nikolayvidenov/Cryorefrigerator/Report/Figures/Top Plate V2.2.jpg

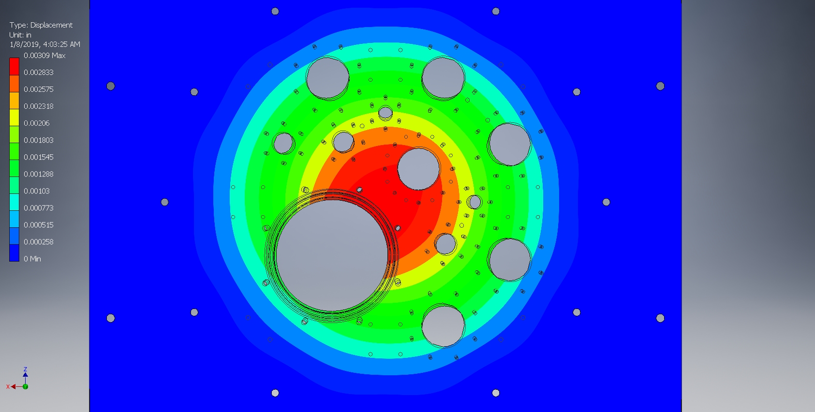
Report/Figures/Top Plate V2.2.jpg
