nikolayvidenov/Cryorefrigerator/Report/Figures/rhalf.jpg

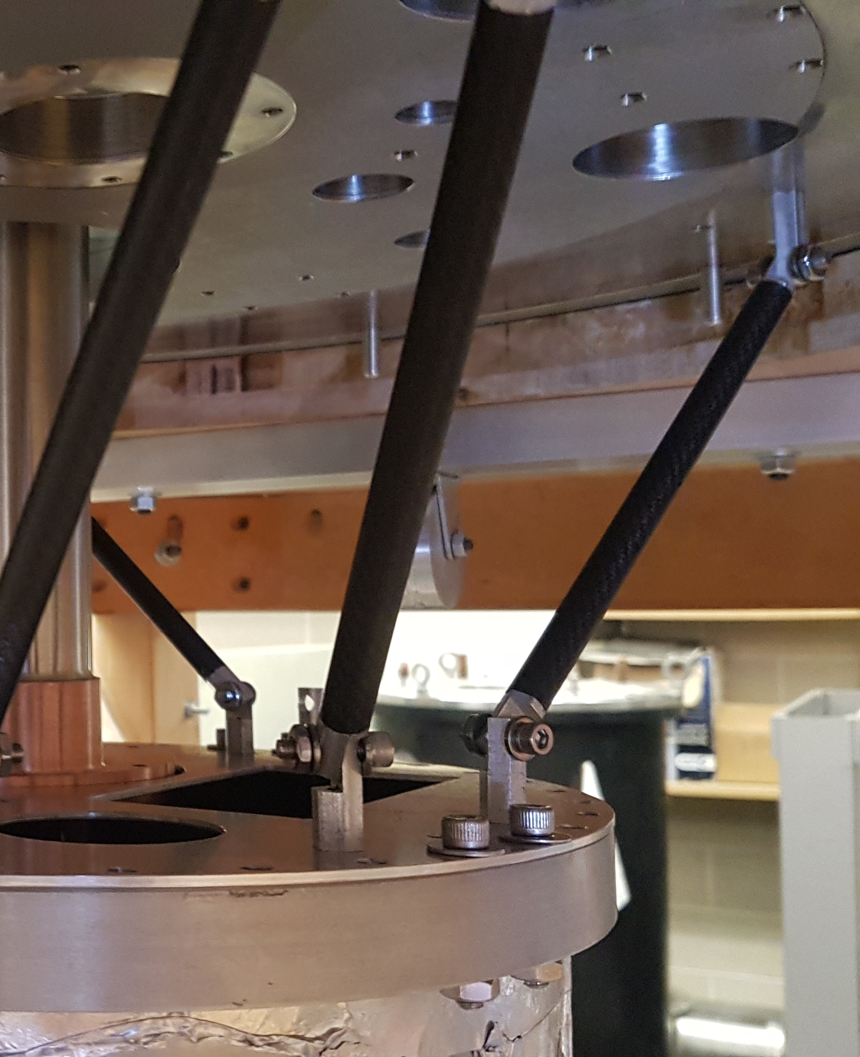
Report/Figures/rhalf.jpg
