nikolayvidenov/Cryorefrigerator/README.md

# Cryostat
Repository for a 4th year research project in cold physics.
