nikolayvidenov/Cryorefrigerator/CAD/References for the Plate Dimensions.docx

## References for the Plate Dimensions

https://www.idealvac.com/product.asp?pid=4601

https://www.lesker.com/newweb/flanges/flanges_technicalnotes_kf_1.cfm

https://www.idealvac.com/product.asp?pid=4599

10/10/18

http://www.mirapro.co.jp/english/products/tubing_components_01_clamps.html

https://www.lesker.com/newweb/flanges/hardware_kf_clamps_bulkhead.cfm?pgid=al
