nikolayvidenov/Cryorefrigerator/Articles/cooling power.PNG

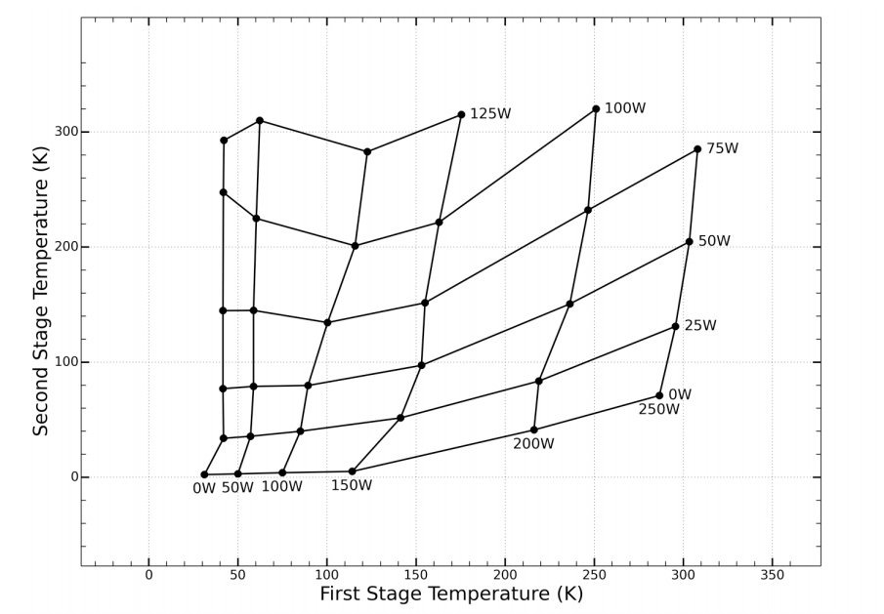
Articles/cooling power.PNG
