nikolayvidenov/Cryorefrigerator/CAD/External Models/Renderings/10-INCH-CLEAT20111201-24373-hxaudv.JPG

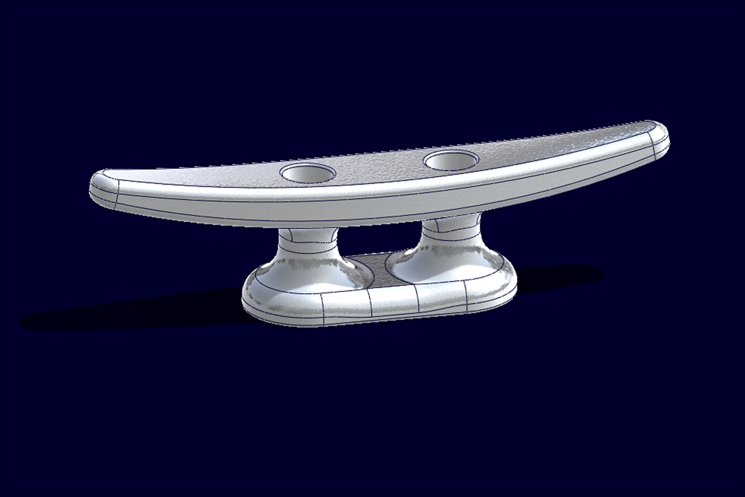
CAD/External Models/Renderings/10-INCH-CLEAT20111201-24373-hxaudv.JPG
