nikolayvidenov/Cryorefrigerator/CAD/lab view of cryostat.jpg

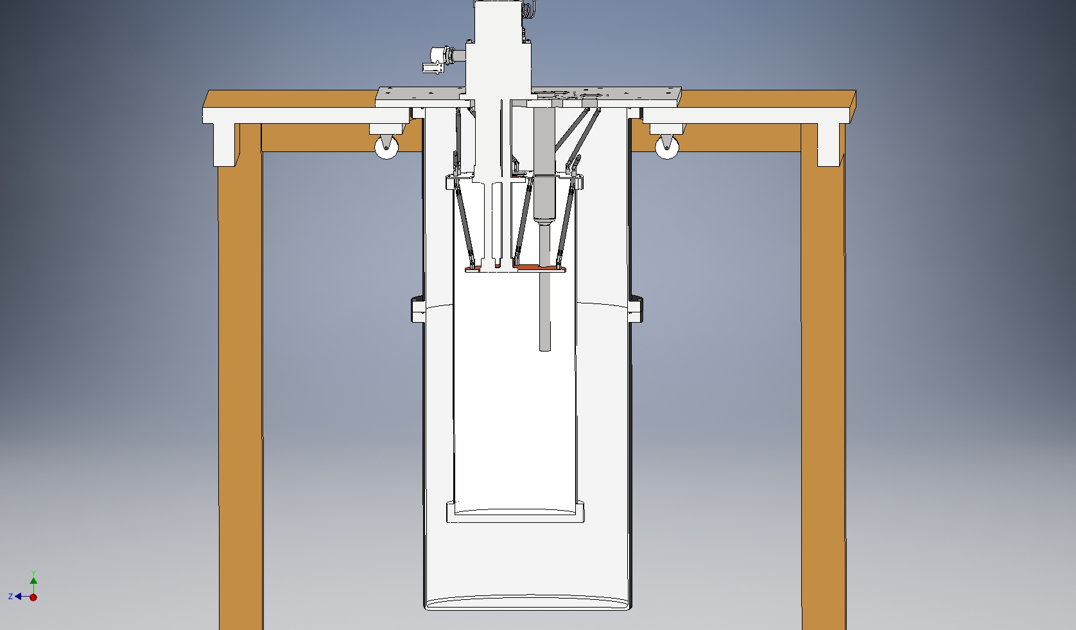
CAD/lab view of cryostat.jpg
