nikolayvidenov/Cryorefrigerator/CAD/stress analysis.jpg

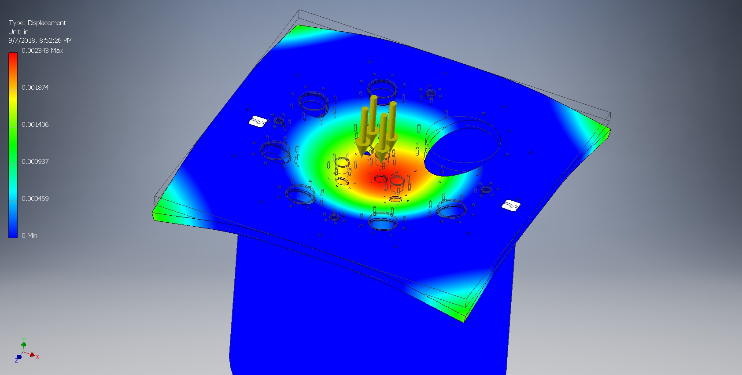
CAD/stress analysis.jpg
