nikolayvidenov/Cryorefrigerator/Calculations/Cool time from Heat Capacity.png

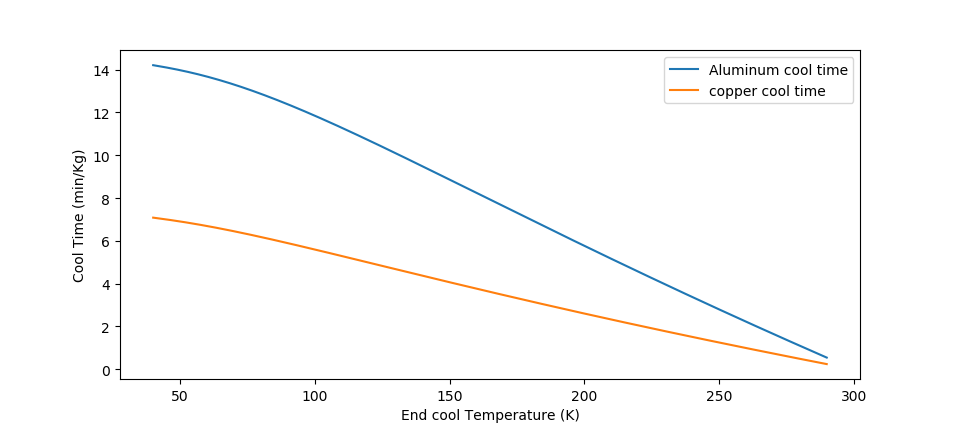
Calculations/Cool time from Heat Capacity.png
