nikolayvidenov/Cryorefrigerator/Cooling2.png

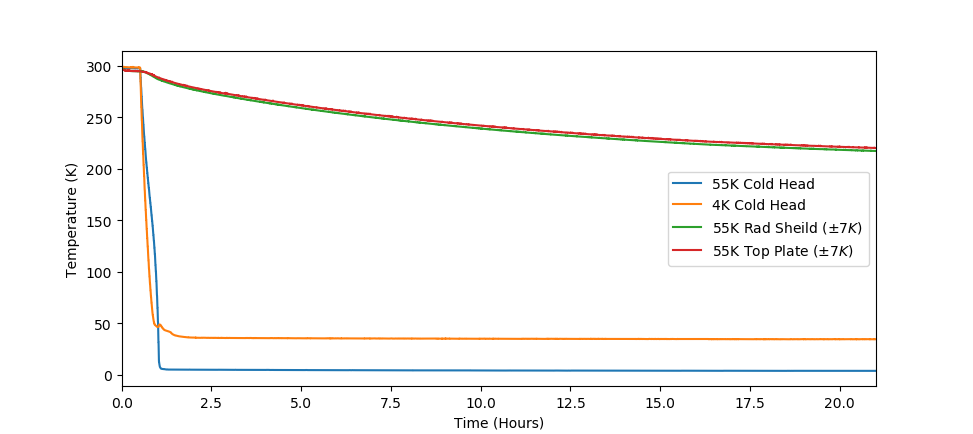
Cooling2.png
