nikolayvidenov/Cryorefrigerator/Cooling.png

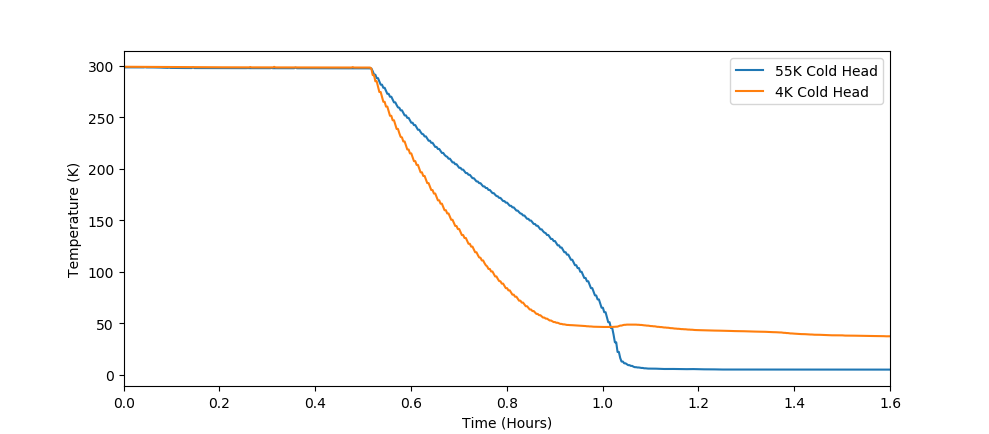
Cooling.png
