nikolayvidenov/Cryorefrigerator/Cryostat bottom.jpg

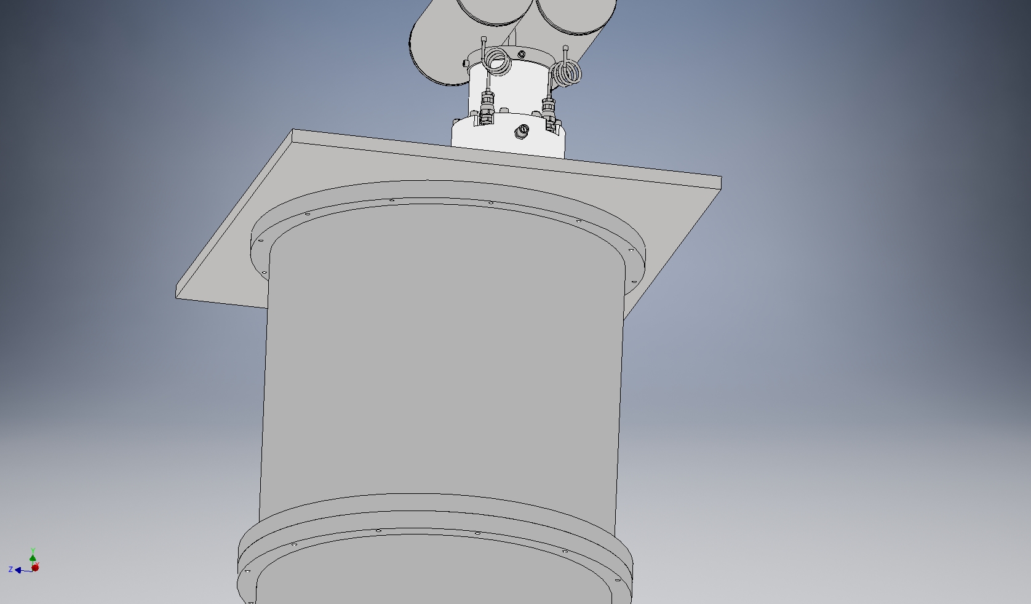
Cryostat bottom.jpg
