nikolayvidenov/Cryorefrigerator/Cryostat.jpg

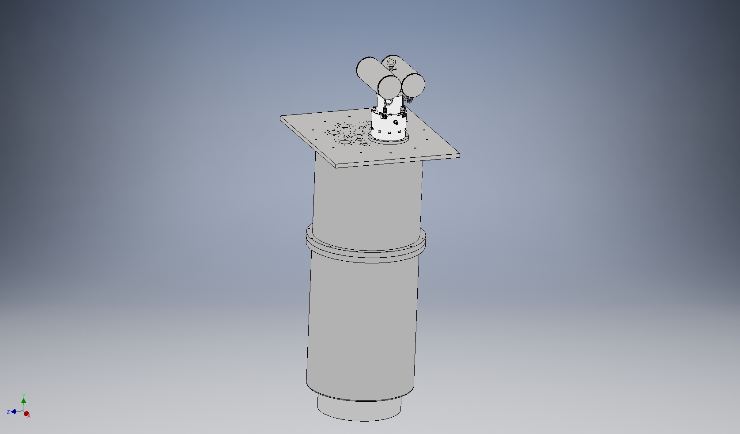
Cryostat.jpg
