nikolayvidenov/Cryorefrigerator/Diagram1.png

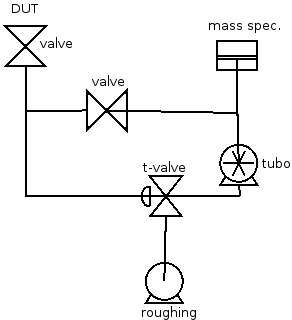
Diagram1.png
