nikolayvidenov/Cryorefrigerator/InkedCryostat bottom_LI.jpg

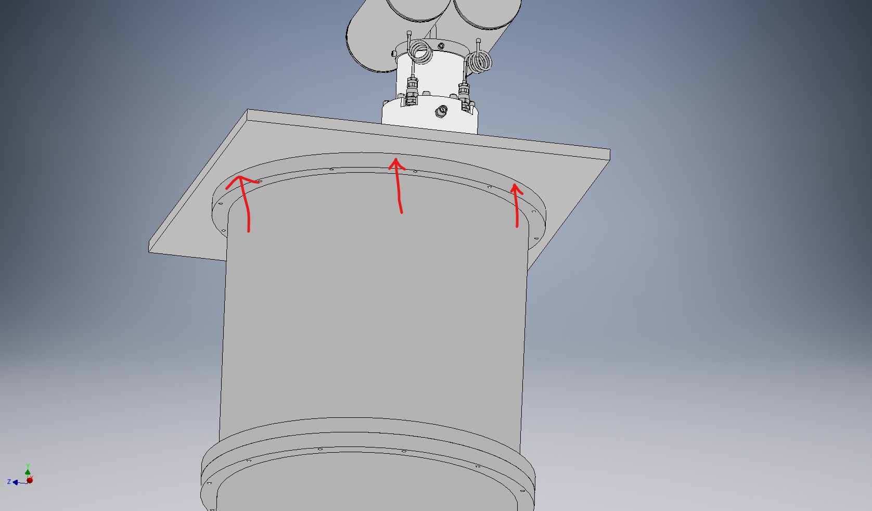
InkedCryostat bottom_LI.jpg
