nikolayvidenov/Cryorefrigerator/Report/Figures/4 wire.jpg

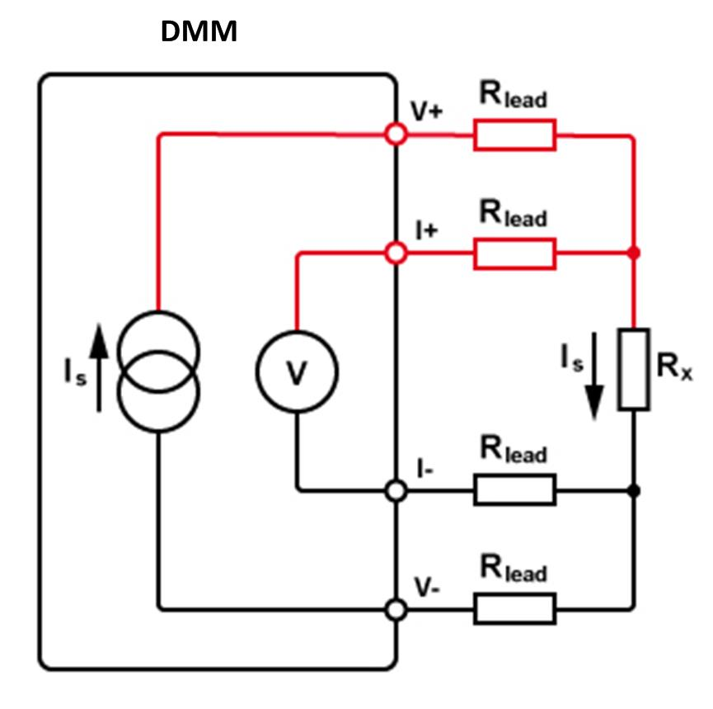
Report/Figures/4 wire.jpg
