nikolayvidenov/Cryorefrigerator/Report/Figures/ezgif.com-crop.gif

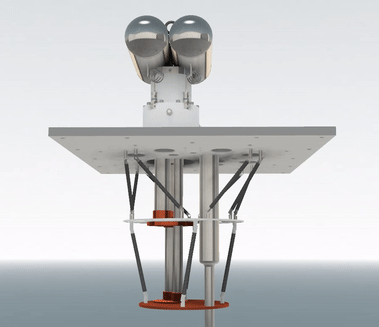
Report/Figures/ezgif.com-crop.gif
