nikolayvidenov/Cryorefrigerator/Report/Figures/foot type 3.jpg

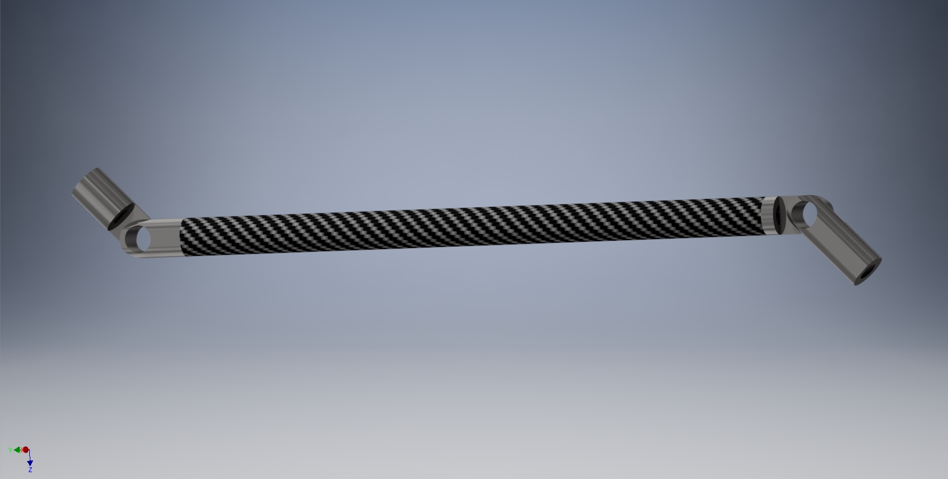
Report/Figures/foot type 3.jpg
