nikolayvidenov/Cryorefrigerator/Report/Figures/footCAD.jpg

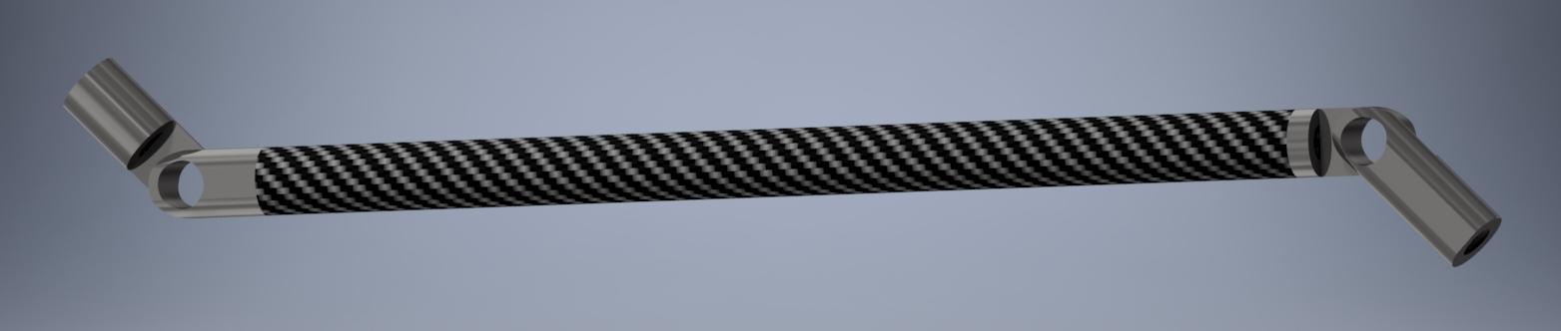
Report/Figures/footCAD.jpg
