nikolayvidenov/Cryorefrigerator/Report/Figures/heat capacity.png

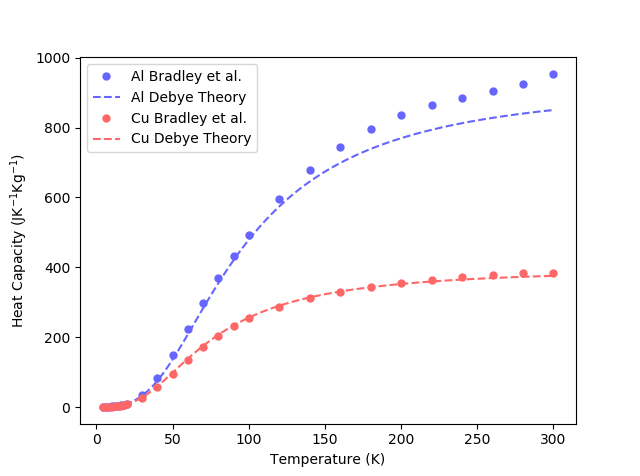
Report/Figures/heat capacity.png
