nikolayvidenov/Cryorefrigerator/Report/Figures/lab view of cryostat2.jpg

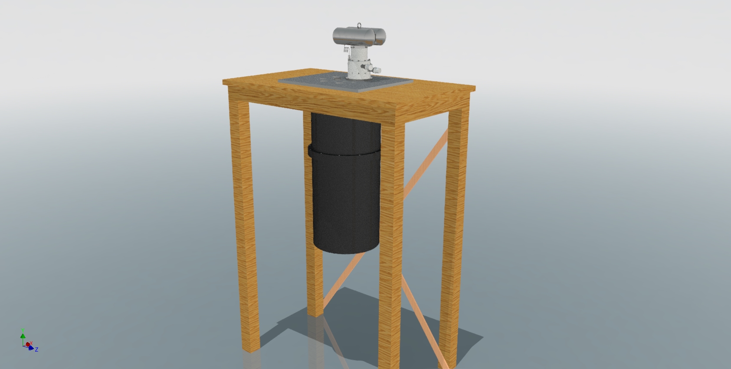
Report/Figures/lab view of cryostat2.jpg
