nikolayvidenov/Cryorefrigerator/Report/Figures/lab view of cryostat3.jpg

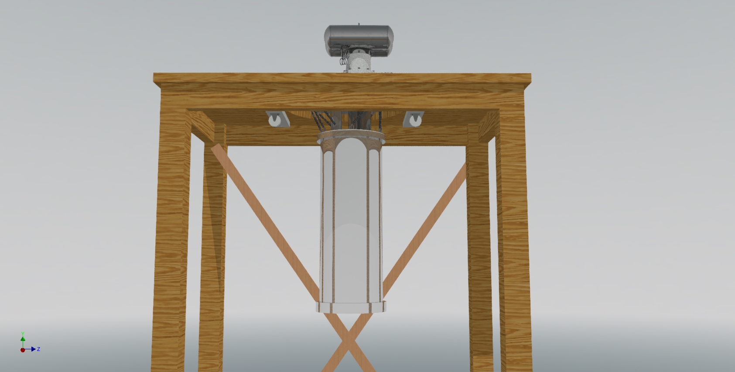
Report/Figures/lab view of cryostat3.jpg
