nikolayvidenov/Cryorefrigerator/Report/Figures/lab view of cryostat.jpg

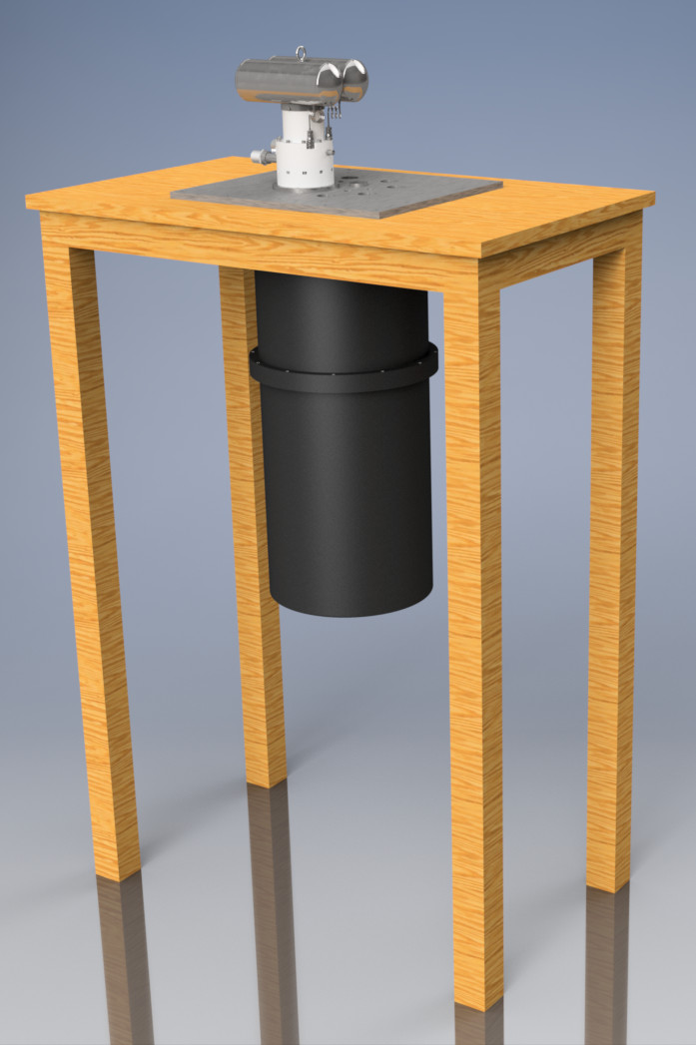
Report/Figures/lab view of cryostat.jpg
