nikolayvidenov/Cryorefrigerator/Report/Figures/lhalf.jpg

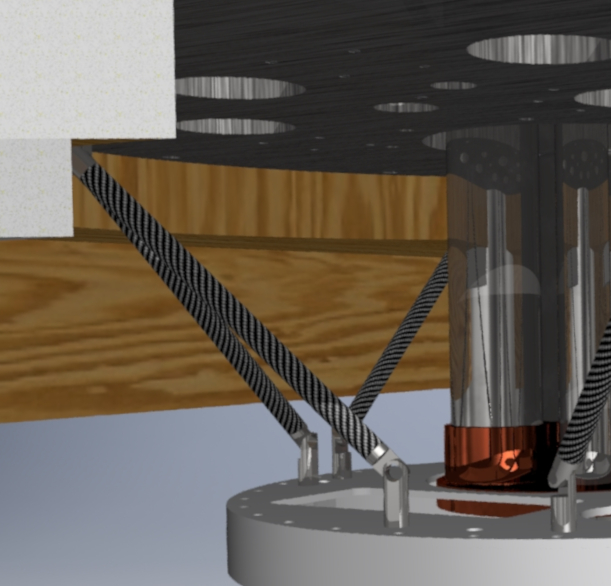
Report/Figures/lhalf.jpg
