nikolayvidenov/Cryorefrigerator/Report/Figures/mini 55K stage2.jpg

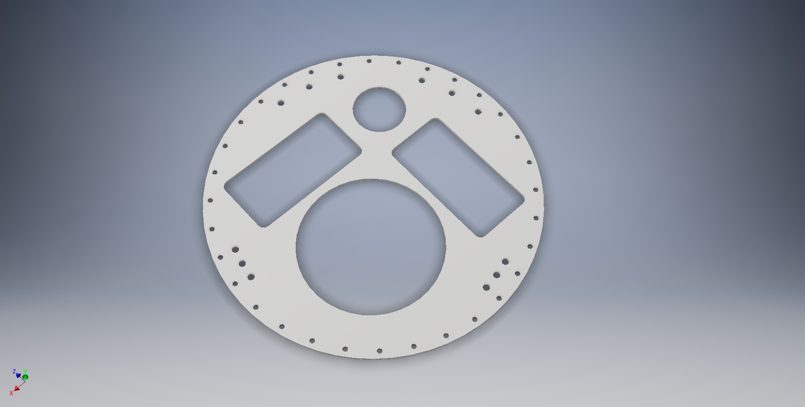
Report/Figures/mini 55K stage2.jpg
