nikolayvidenov/Cryorefrigerator/Report/Figures/mini 55K stage.jpg

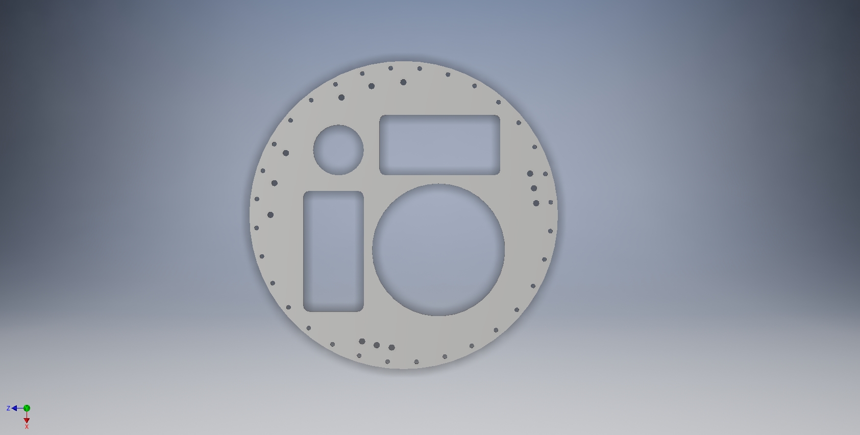
Report/Figures/mini 55K stage.jpg
