nikolayvidenov/Cryorefrigerator/Report/Figures/PTCOOLER.jpg

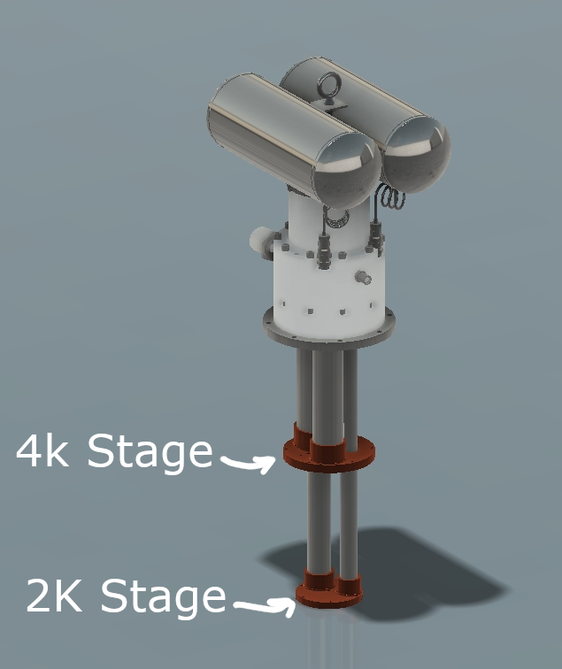
Report/Figures/PTCOOLER.jpg
