nikolayvidenov/Cryorefrigerator/Report/Figures/reallab view of cryostat.jpg

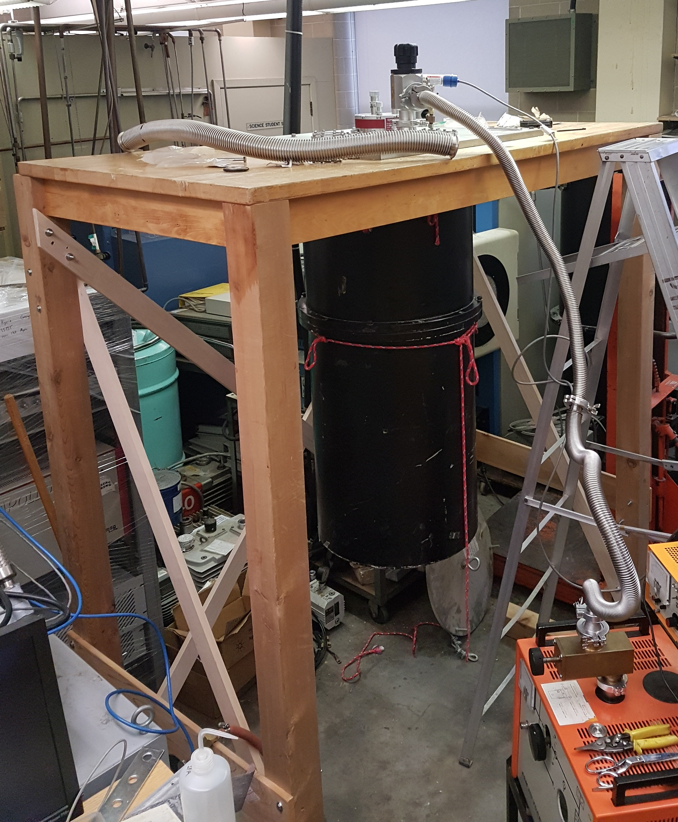
Report/Figures/reallab view of cryostat.jpg
