nikolayvidenov/Cryorefrigerator/Report/Figures/Top Plate V2.2 saftey factor.jpg

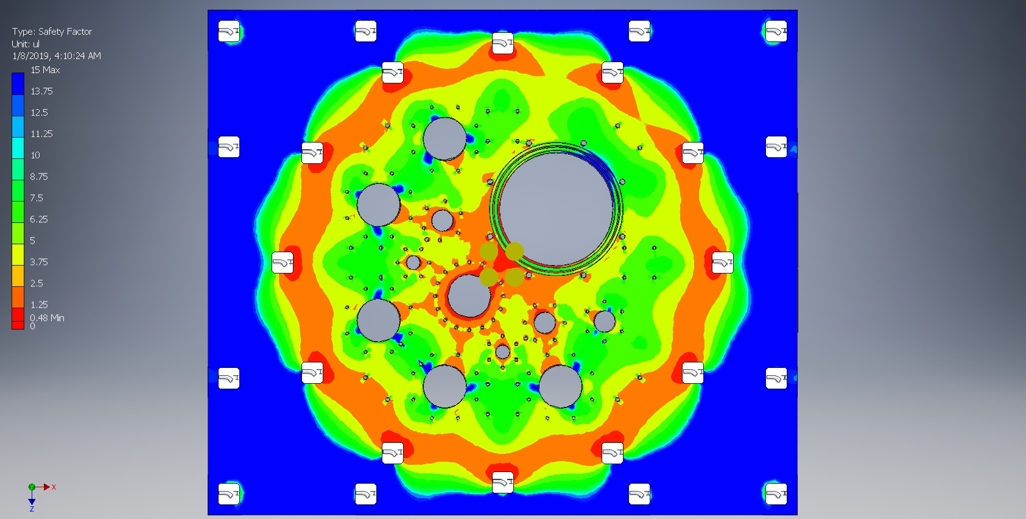
Report/Figures/Top Plate V2.2 saftey factor.jpg
