nikolayvidenov/Cryorefrigerator/Report/Figures/Top Plate V2.2 sideview.jpg

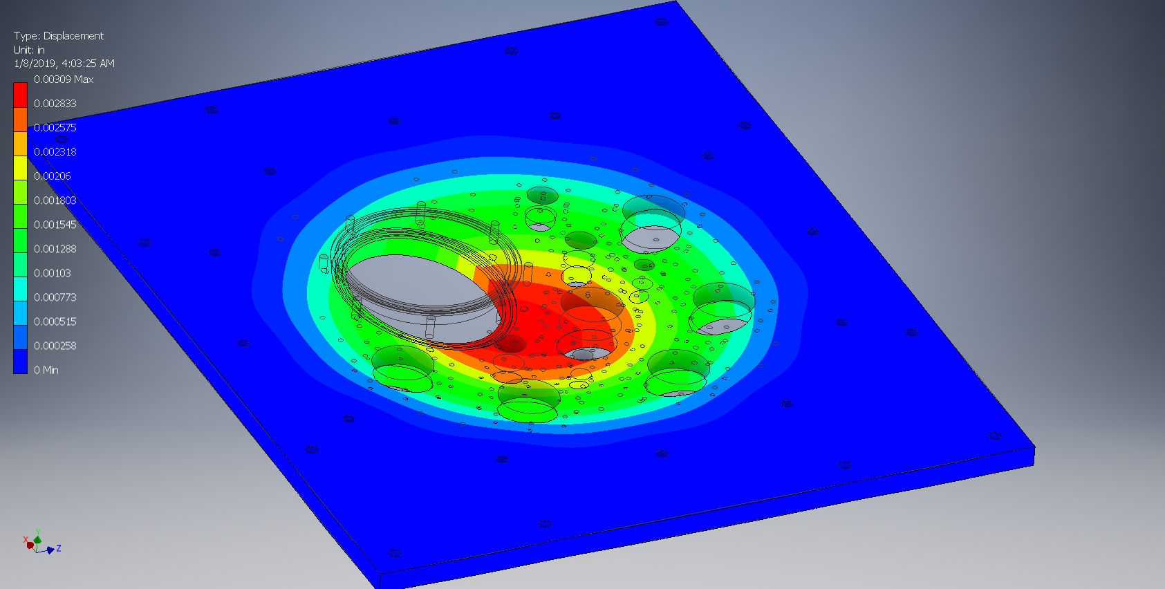
Report/Figures/Top Plate V2.2 sideview.jpg
