nikolayvidenov/Cryorefrigerator/Report/Figures/upview2.jpg

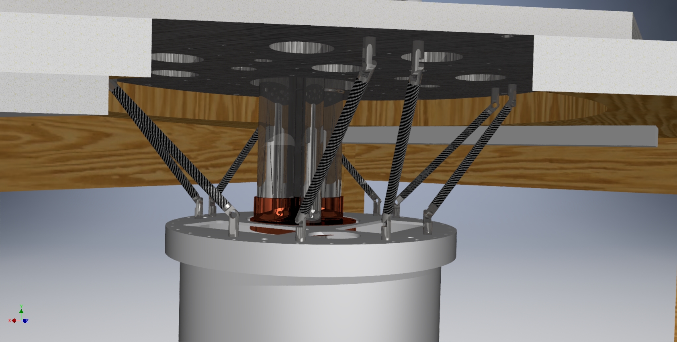
Report/Figures/upview2.jpg
