nikolayvidenov/Cryorefrigerator/Report/Figures/upview.jpg

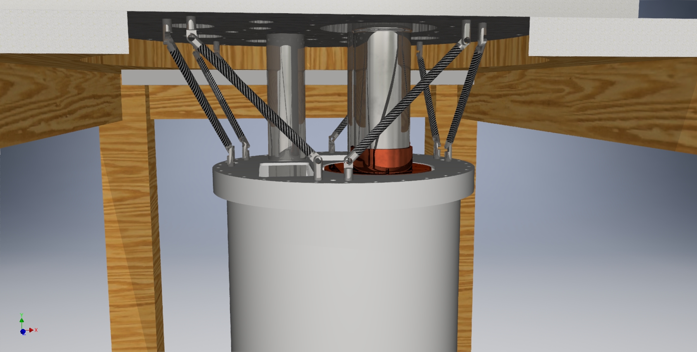
Report/Figures/upview.jpg
