nikolayvidenov/Cryorefrigerator/ReportB/Figures/4KColdHead.png

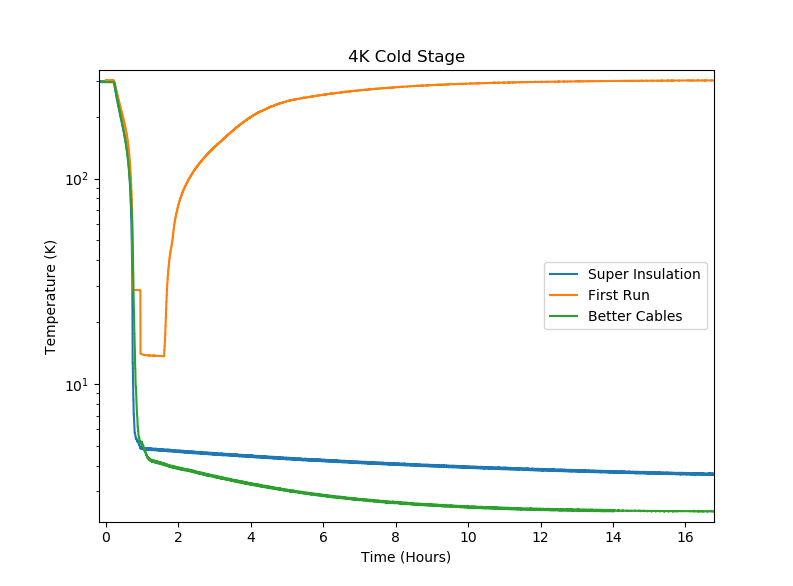
ReportB/Figures/4KColdHead.png
