nikolayvidenov/Cryorefrigerator/ReportB/Figures/55KColdHead.png

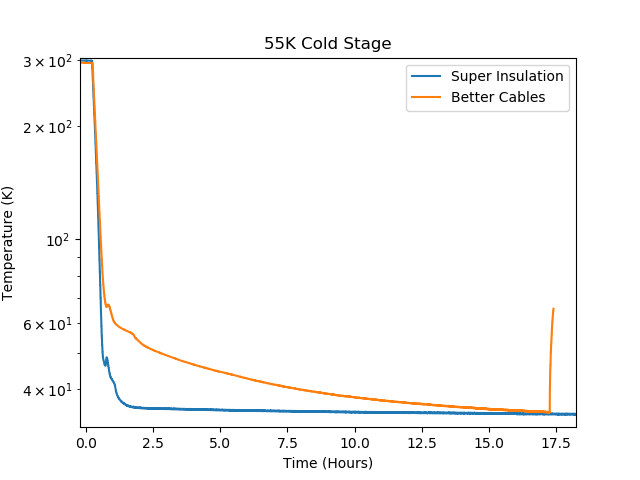
ReportB/Figures/55KColdHead.png
