nikolayvidenov/Cryorefrigerator/ReportB/Figures/55KScafolding.png

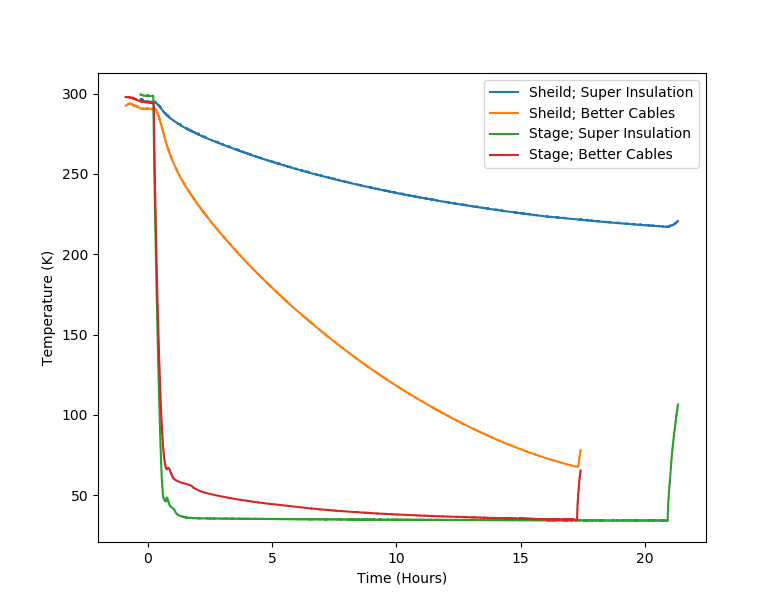
ReportB/Figures/55KScafolding.png
