nikolayvidenov/Cryorefrigerator/ReportB/Figures/mini Cryostat FOOT3.png

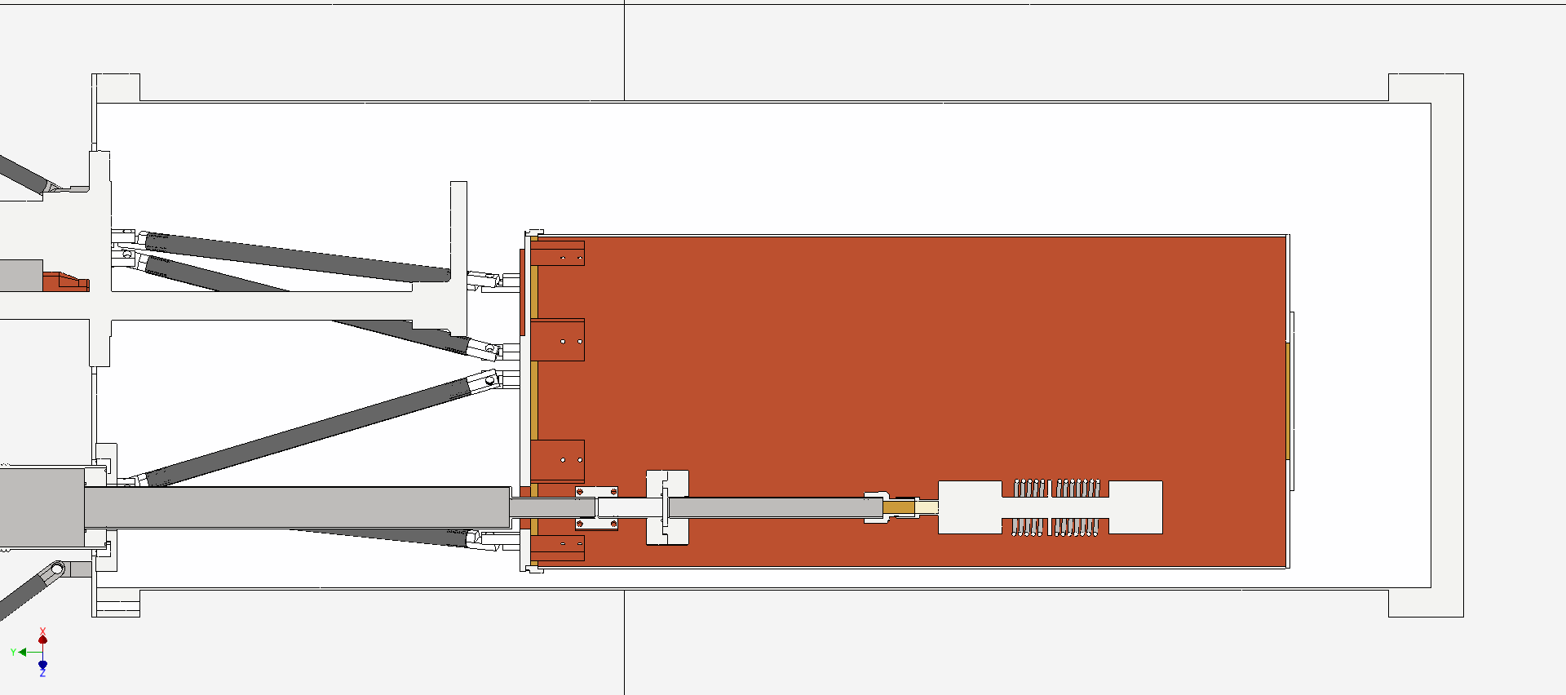
ReportB/Figures/mini Cryostat FOOT3.png
