nikolayvidenov/Cryorefrigerator/ReportB/Figures/mini Cryostat FOOT32.png

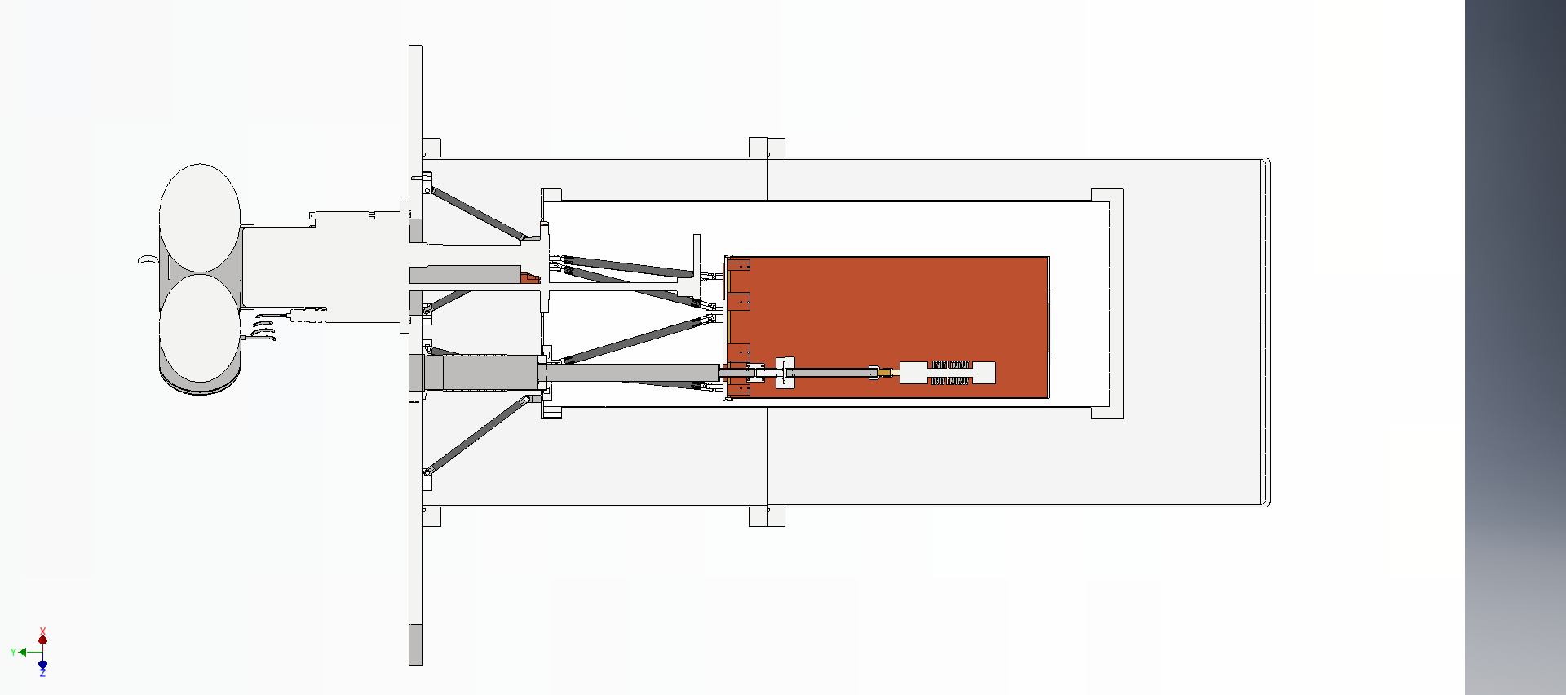
ReportB/Figures/mini Cryostat FOOT32.png
