nikolayvidenov/Cryorefrigerator/ReportB/Figures/still pipe.png

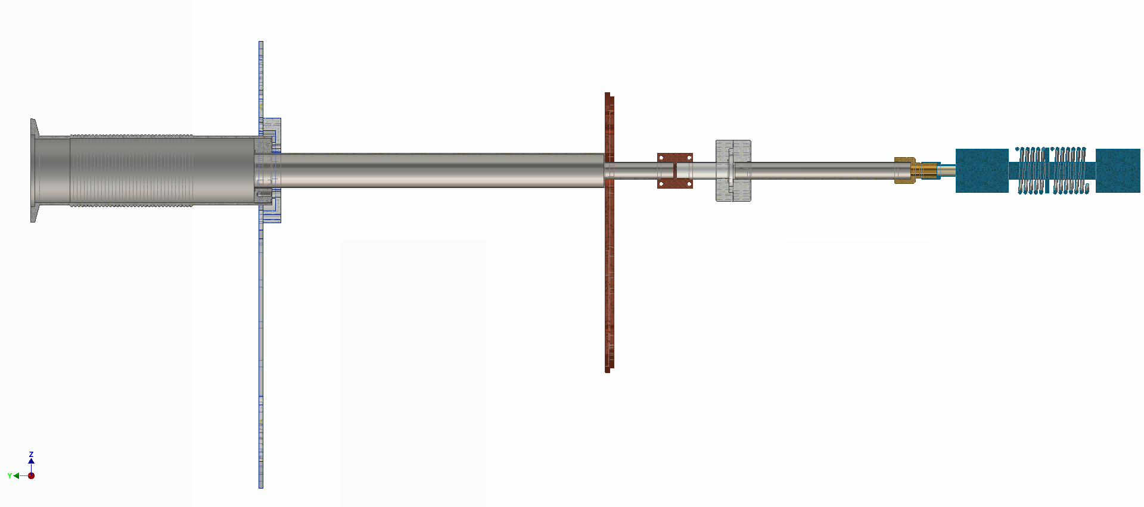
ReportB/Figures/still pipe.png
