nikolayvidenov/Cryorefrigerator/CAD/External Models/MARINE-CLEAT.STEP

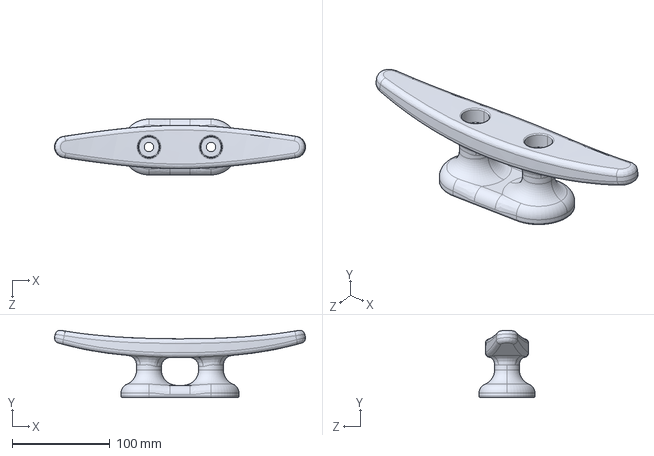
[picture p37: CAD file, 2018-10-26]
CAD/External Models/MARINE-CLEAT.STEP
256.9 x 69.1 x 57.2 mm
