nikolayvidenov/Cryorefrigerator/CAD/External Models/kf16 bulkhead clamp.stp

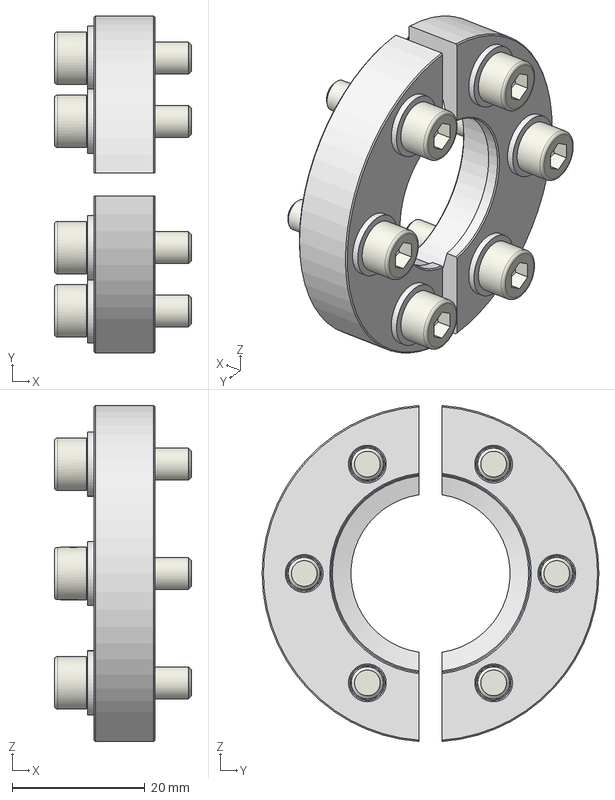
[picture p38: CAD file, 2018-09-08]
CAD/External Models/kf16 bulkhead clamp.stp
20.7 x 50.8 x 50.7 mm
QF16-075-BC
SOCKET HEAD CAP SCREW #10-32 x 6
WASHER #10 x 6
