nikolayvidenov/Cryorefrigerator/CAD/External Models/kf25 bulkhead clamp.stp

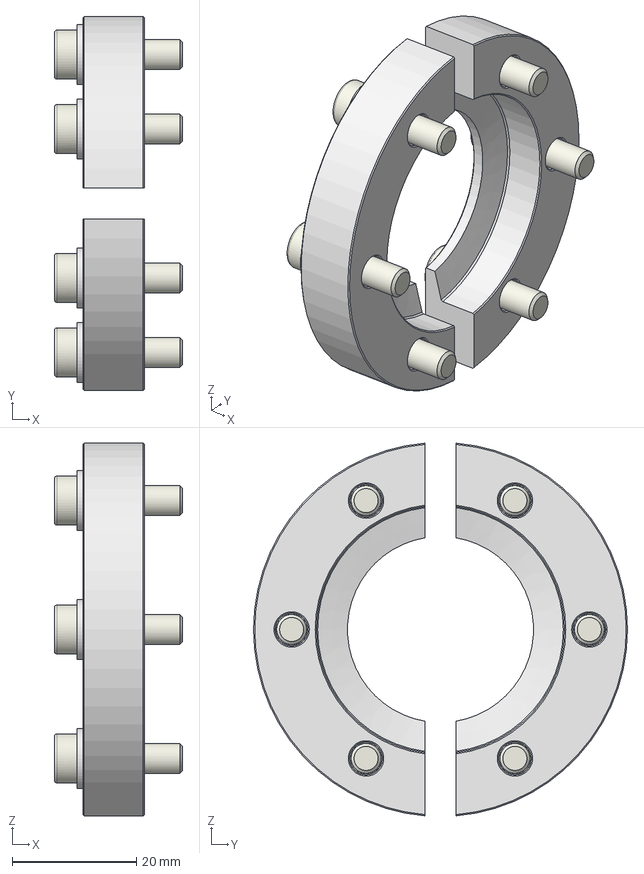
[picture p39: CAD file, 2018-08-22]
CAD/External Models/kf25 bulkhead clamp.stp
20.7 x 60.3 x 60.1 mm
QF25-100-BC
SOCKET HEAD CAP SCREW #10-32 x 6
WASHER #10 x 6
