nikolayvidenov/Cryorefrigerator/CAD/External Models/kf50 bulkhead clamp.stp

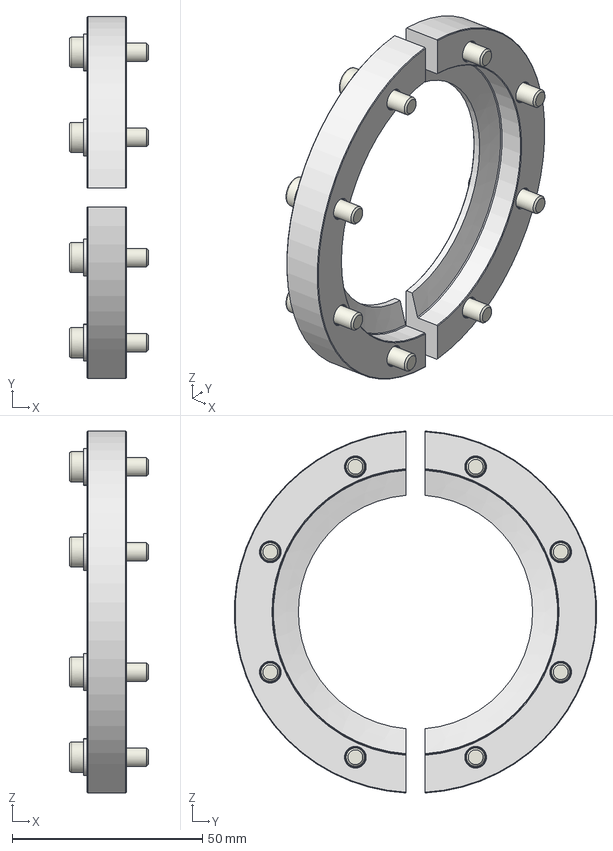
[picture p40: CAD file, 2018-08-22]
CAD/External Models/kf50 bulkhead clamp.stp
20.7 x 95.1 x 95.1 mm
QF50-200-BC
WASHER #10 x 8
SOCKET HEAD CAP SCREW #10-32 x 8
