nikolayvidenov/Cryorefrigerator/CAD/Top Plate V3 back holes.stp

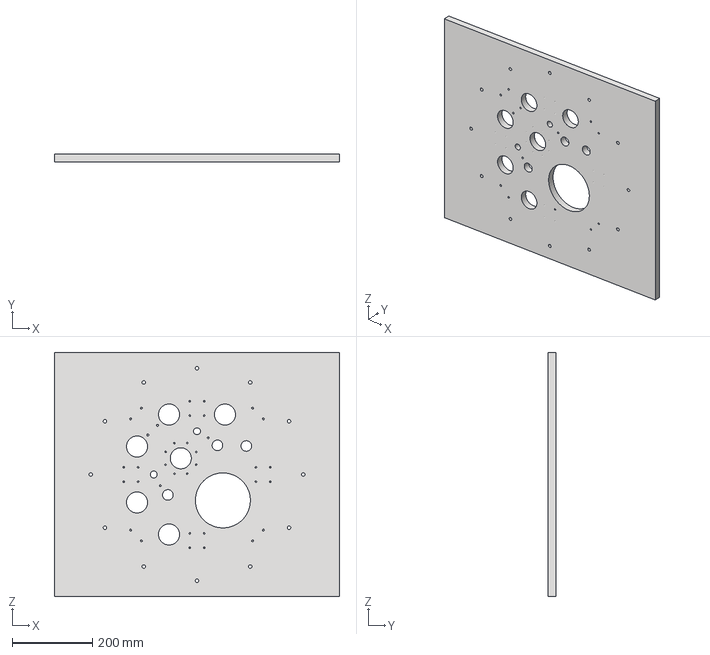
[picture p41: CAD file, 2018-11-19]
CAD/Top Plate V3 back holes.stp
711.2 x 19.0 x 609.6 mm
