nikolayvidenov/Cryorefrigerator/CAD/Top Plate.stp

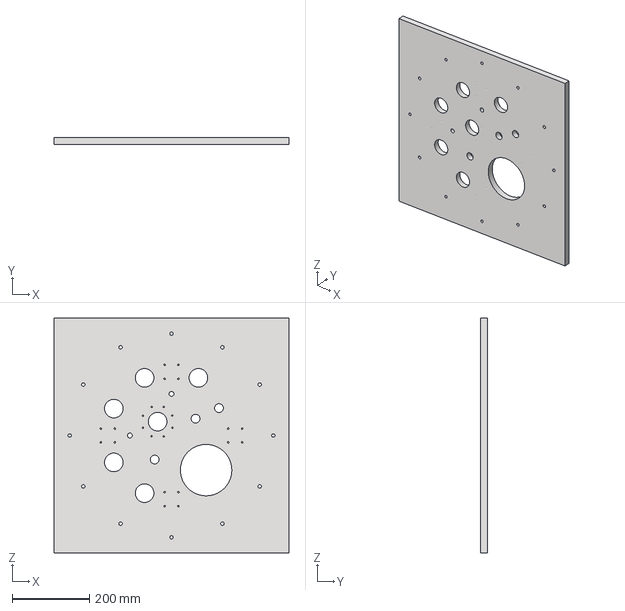
[picture p42: CAD file, 2018-09-15]
CAD/Top Plate.stp
609.6 x 19.1 x 609.6 mm
