nikolayvidenov/Cryorefrigerator/(list of files, cad)

Other CAD files:
CAD/universal connector male.dwg
CAD/still pipe.dwg
CAD/heatsink.dwg
CAD/fridge bushing.dwg
CAD/adapter.dwg
CAD/brassbushing2.dwg
CAD/mount.dwg
CAD/TF JunctionBoard.dwg
CAD/TF readoutSquid.dwg
CAD/8 trace.dwg
CAD/teflonlense assem.dwg
CAD/feet type 3 part 1.dwg
CAD/feet type 3 part 2.dwg
CAD/Top Plate V2 mounting holes.dwg
CAD/Top Plate V2 PT415 moved in.dwg
CAD/Top Plate PT415 grooves.dwg
CAD/Top Plate V2.2.dwg
CAD/Top Plate V2 oring.dwg
CAD/Top Plate Dimentions KF16.dwg
CAD/Top Plate Simple.dwg
CAD/Top Plate Dimentions KF25.dwg
CAD/Top Plate Dimentions KF50.dwg
CAD/Top Plate Dimentions.dwg
CAD/0in5 ss pipe.ipt
CAD/1in ss pipe.ipt
CAD/2K8 FEET long.iam
CAD/2K8 FEET.iam
CAD/2K8 stage mini.ipt
CAD/2K8 stage.ipt
CAD/4K adapter.ipt
CAD/4K heatsink bushing.ipt
CAD/4K sheild body.ipt
CAD/4K sheild body2.ipt
CAD/4K sheild rim.ipt
CAD/4K sheild rim2.ipt
CAD/4K sheild rim3.ipt
CAD/4K sheild top.ipt
CAD/4K shield bottom.ipt
CAD/4K shield cover.ipt
CAD/4K shield.iam
CAD/4K shield2.iam
CAD/55K mini shield.ipt
CAD/55K shield sheet.ipt
CAD/55K stage comparison.iam
CAD/55K stage.ipt
CAD/8 trace.ipt
CAD/Cryostat top plate.iam
CAD/Cryostat.iam
CAD/External Models/CH40415 24JUL14 C.ipt
CAD/External Models/CH40415 24JUL14 C.stp
CAD/External Models/MARINE-CLEAT.ipt
CAD/External Models/MARINE-CLEAT.stl
CAD/External Models/OldVersions/CH40415 24JUL14 C.0003.ipt
CAD/External Models/OldVersions/MARINE-CLEAT.0001.ipt
CAD/External Models/OldVersions/SOCKET HEAD CAP SCREW #10-32.0001.ipt
CAD/External Models/OldVersions/SOCKET HEAD CAP SCREW #10-32.0002.ipt
CAD/External Models/OldVersions/WASHER #10.0001.ipt
CAD/External Models/OldVersions/WASHER #10.0002.ipt
CAD/External Models/OldVersions/kf16 bulkhead clamp.0001.iam
CAD/External Models/QF16-075-BC.ipt
CAD/External Models/QF25-100-BC.ipt
CAD/External Models/QF50-200-BC.ipt
CAD/External Models/SOCKET HEAD CAP SCREW #10-32.ipt
CAD/External Models/WASHER #10.ipt
CAD/External Models/kf16 bulkhead clamp.iam
CAD/External Models/kf25 bulkhead clamp.iam
CAD/External Models/kf50 bulkhead clamp.iam
CAD/KF50 bellows.ipt
CAD/OldVersions/0in5 ss pipe.0001.ipt
CAD/OldVersions/1in ss pipe.0012.ipt
CAD/OldVersions/2K8 FEET long.0011.iam
CAD/OldVersions/2K8 FEET.0012.iam
CAD/OldVersions/2K8 stage mini.0007.ipt
CAD/OldVersions/2K8 stage.0002.ipt
CAD/OldVersions/4K heatsink bushing.0003.ipt
CAD/OldVersions/4K sheild rim3.0001.ipt
CAD/OldVersions/4K sheild top.0021.ipt
CAD/OldVersions/4K shield bottom.0002.ipt
CAD/OldVersions/4K shield2.0009.iam
CAD/OldVersions/55K mini shield.0004.ipt
CAD/OldVersions/55K shield sheet.0001.ipt
CAD/OldVersions/55K stage.0020.ipt
CAD/OldVersions/8 trace.0001.ipt
CAD/OldVersions/Cryostat top plate.0005.iam
CAD/OldVersions/Cryostat top plate.0006.iam
CAD/OldVersions/Cryostat.0016.iam
CAD/OldVersions/KF50 bellows.0008.ipt
CAD/OldVersions/Radiation Sheild 2K.0004.ipt
CAD/OldVersions/TF JunctionBoard.0002.ipt
CAD/OldVersions/TF readoutSquid.0001.ipt
CAD/OldVersions/Top Plate Dimentions KF16.0003.dwg
CAD/OldVersions/Top Plate Dimentions KF25.0003.dwg
CAD/OldVersions/Top Plate Dimentions KF50.0003.dwg
CAD/OldVersions/Top Plate Dimentions.0005.dwg
CAD/OldVersions/Top Plate PT415 grooves.0003.dwg
CAD/OldVersions/Top Plate Simple.0001.dwg
CAD/OldVersions/Top Plate V2 mounting holes.0004.dwg
CAD/OldVersions/Top Plate V2.0007.ipt
CAD/OldVersions/Top Plate V2.2.0023.ipt
CAD/OldVersions/Top Plate.0015.ipt
CAD/OldVersions/Top Plate.0032.ipt
CAD/OldVersions/adapter.0001.dwg
CAD/OldVersions/adapter.0010.ipt
CAD/OldVersions/analysis.0003.iam
CAD/OldVersions/analysis.0004.iam
CAD/OldVersions/brassbushing2.0001.dwg
CAD/OldVersions/brassbushing2.0004.ipt
CAD/OldVersions/existing copper plate 1.0001.ipt
CAD/OldVersions/existing copper plate 2.0001.ipt
CAD/OldVersions/feet type 1 part 2.0001.ipt
CAD/OldVersions/feet type 1 part 2.0002.ipt
CAD/OldVersions/feet type 1 part 2.0003.ipt
CAD/OldVersions/feet type 2 part 1.0001.ipt
CAD/OldVersions/feet type 2 part 2 long.0001.ipt
CAD/OldVersions/feet type 2 part 2.0001.ipt
CAD/OldVersions/feet type 2 part 2.0002.ipt
CAD/OldVersions/feet type 3 part 1 hexagon stock 10-32 hole.0002.ipt
CAD/OldVersions/feet type 3 part 1 hexagon stock.0002.ipt
CAD/OldVersions/feet type 3 part 2 hex stock 10-32.0002.ipt
CAD/OldVersions/feet type 3 part 3 2k8 length SHORT.0002.ipt
CAD/OldVersions/feet type 3 part 3 2k8 length.0014.ipt
CAD/OldVersions/feet type 3 part 3.0005.ipt
CAD/OldVersions/feet type 3 part 3.0005_1.ipt
CAD/OldVersions/foot type 1.0002.iam
CAD/OldVersions/foot type 2 length 2.0001.iam
CAD/OldVersions/foot type 2 length 2.0002.iam
CAD/OldVersions/foot type 2.0001.iam
CAD/OldVersions/foot type 3.0009.iam
CAD/OldVersions/fridge bushing.0005.ipt
CAD/OldVersions/heatsink.0007.ipt
CAD/OldVersions/lab view of cryostat.0009.iam
CAD/OldVersions/mini 55K stage.0045.ipt
CAD/OldVersions/mini Cryostat FOOT3.0049.iam
CAD/OldVersions/mini Cryostat.0005.iam
CAD/OldVersions/minifridge.0004.ipt
CAD/OldVersions/mount.0006.ipt
CAD/OldVersions/pipeshift.0003.ipt
CAD/OldVersions/plug.0001.ipt
CAD/OldVersions/pulley holder.0001.ipt
CAD/OldVersions/pulley wheel.0001.ipt
CAD/OldVersions/pulley.0004.iam
CAD/OldVersions/ridgidity analysis.0004.iam
CAD/OldVersions/ridgidity analysis2.0001.iam
CAD/OldVersions/silverSolderJoint.0001.ipt
CAD/OldVersions/ss pipe for still.0001.ipt
CAD/OldVersions/still pipe small.iam.0006.ipt
CAD/OldVersions/still pipe standin.0001.ipt
CAD/OldVersions/still pipe.0003.dwg
CAD/OldVersions/still pipe.0023.iam
CAD/OldVersions/table reinforcement.0002.ipt
CAD/OldVersions/table.0003.ipt
CAD/OldVersions/teflonlense assem.0002.dwg
CAD/OldVersions/teflonlense assem.0004.ipt
CAD/OldVersions/universal connector male.0004.ipt
CAD/OldVersions/universal connector.0005.ipt
CAD/OldVersions/vacuum jacket long.0006.ipt
CAD/OldVersions/vacuum jacket.0004.ipt
CAD/OldVersions/weldpart.0003.ipt
CAD/Radiation Sheild 2K.ipt
CAD/Radiation Sheild 55K bottom.ipt
CAD/Radiation Sheild 55K.ipt
CAD/Stiffness Analysis.iam
CAD/TF JunctionBoard.ipt
CAD/TF readoutSquid.ipt
CAD/Top Plate V1.dwg
CAD/Top Plate V2.2.ipt
CAD/adapter.ipt
CAD/analysis.iam
CAD/brassbushing.ipt
CAD/brassbushing2.ipt
CAD/cold feet.iam
CAD/connected connectors.iam
CAD/cy oring.ipt
CAD/existing copper plate 1.ipt
CAD/existing copper plate 2.ipt
CAD/feet type 1 part 1.ipt
CAD/feet type 1 part 2.ipt
CAD/feet type 2 part 1.ipt
CAD/feet type 2 part 2 long.ipt
CAD/feet type 2 part 2.ipt
CAD/feet type 3 part 1 hexagon stock 10-32 hole.ipt
CAD/feet type 3 part 1 hexagon stock.ipt
CAD/feet type 3 part 1.ipt
CAD/feet type 3 part 2 hex stock 10-32.ipt
CAD/feet type 3 part 2.ipt
CAD/feet type 3 part 3 2k8 length SHORT.ipt
CAD/feet type 3 part 3 2k8 length.ipt
CAD/feet type 3 part 3.ipt
CAD/foot type 1.iam
CAD/foot type 2 length 2.iam
CAD/foot type 2.iam
CAD/foot type 3 short.iam
CAD/foot type 3.iam
CAD/fridge bushing.ipt
CAD/heatsink.ipt
CAD/lab view of cryostat.iam
CAD/mini 55K stage.ipt
CAD/mini Cryostat FOOT3.iam
CAD/mini Cryostat.iam
CAD/minifridge.ipt
CAD/mount.ipt
CAD/pipeshift.ipt
CAD/plug.ipt
CAD/pulley holder.ipt
CAD/pulley wheel.ipt
CAD/pulley.iam
CAD/ridgidity analysis.iam
CAD/ridgidity analysis2.iam
CAD/sheild stop.ipt
CAD/silverSolderJoint.ipt
CAD/ss pipe for still.ipt
CAD/still pipe small.iam.ipt
CAD/still pipe standin.ipt
CAD/still pipe unmodified.ipt
CAD/still pipe.iam
CAD/table reinforcement.ipt
CAD/table.ipt
CAD/teflonlense assem.ipt
CAD/universal connector male.ipt
CAD/universal connector.ipt
CAD/vacuum jacket long.ipt
CAD/vacuum jacket.ipt
CAD/weldpart.ipt
