nikolayvidenov/Cryorefrigerator/Report/Figures/ezgif.com-gif-maker (1).gif

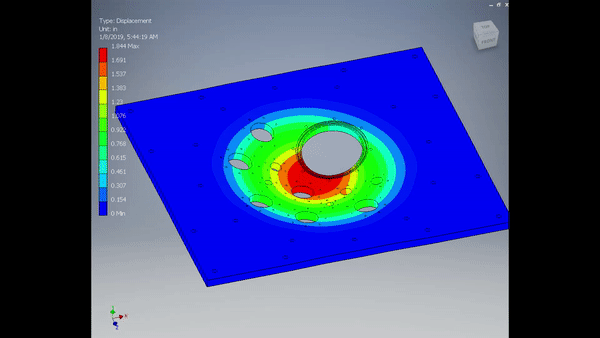
Report/Figures/ezgif.com-gif-maker (1).gif
