nikolayvidenov/Cryorefrigerator/Basic Bringup.docx

# Basic Bringup: Cryorefrigerator

# Introduction

This document is an ongoing document detailing the current status of the quick test cryorefrigerator. The intent of this document is to note current problems and attempted solutions as well as providing a history for the project.

# Goals

The goal of this project is to make a cold chamber that can quickly and cost effectively reach ~1K temperatures. The use for this system would be quick tests of samples prior to placing them in the main cryostats that take ages to reach temperature.

# Ongoing Notes

- Support (Table)
  - Assemble Table now that hole has been cut
- Counter weight (pulley for jacket)
  - Thinking of using straps instead of something hard, should reduce stress and risk of flipping
- Design/make 55K/2.8K stage/shield
    - Aluminum sheet thickness for rolling our own.
  - Using existing tube for mini 55K shield
  - Do a complete cooldown analysis
  - 2.8k stage should have a 1” total clearance
  - Additional cooling calculations for the 2.8K stage
- Braded heat transfer
  - Thermal conductivity is proportional to electrical conductivity
  - Ask grand river welding if they can weld copper
  - Machine and test copper clamping instead of welding.
    - Copper welding is doable by grand valley welding
      - The even have laser welding capabilities
  - Got copper lugs and cable
  - Found a paper which lists conductivity of crimped copper using 4wire method.
- Still line
  - Pull apart the jumble of steel pipes
- Wires
  - Electrical
  - Thermal
- Vacuum pump
  - Test out seal quality?
  - Do we have an o-ring for the vacuum jacket?
- Thermometry
- 1K pot

# Stress analysis

Inventor professional has a built in FEM solver for stress. Using this tool it is straightforward to get a rough idea of the deflection which the plate will see under vacuum. A pressure of 15psi was applied to the surface of the plate with the vacuum jacket marked as an immovable object. The result of the calculations is shown in the image below. The takeaway is that for a ¾” austenitic stainless steel plate a maximal deflection of 0.002” is expected.

This is of course just a simulated estimation. Some limitations include gravity not being factored in, using a generic austenitic steel grade for the simulation instead of specifying 316L stainless steel (for example). Also, the weight and the added rigidity of having the flanges populated with equipment was ignored for this test.

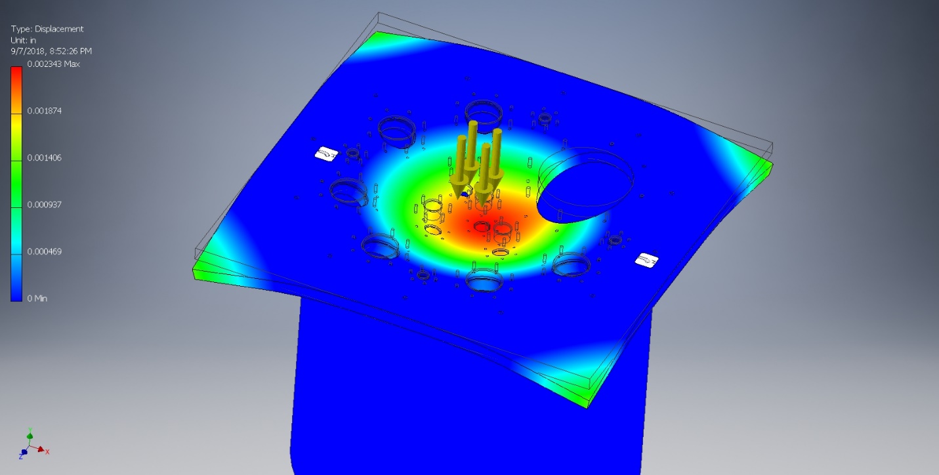
[picture p44: figure]

A further test with gravity found no difference. Also initial investigations into the natural harmonics of the steel plate show that modifying the orientation of the holes does not have a significant effect on the dominant vibrational mode. You can see that the spherical harmonics for a disk are predominant (as expected) with additional modes due to the corners vibrating.

# Top Plate Design

## Spira EMI shielding

Spria-shield is a product manufactured by Spira manufacturing. This product looks like a long metal spiral made of a flat continuous strip of metal. The intended use of Spira is providing EMI shielding by sandwiching the Spira between two metal surfaces. The Spira then provides conductive contact between the two metal surfaces screening EMI.

In talking with sales reps from Spira they informed us that for the Spira to effectively screen EMI it must be at 20-25% compression with 25% being the ideal, and that moving away from this ideal compression leads to a rapid drop off in EMI shielding performance.

## Vacuum Jacket Bolt Pattern

The vacuum jacket bolt pattern has been measured properly. Test holes drilled in acrylic with the desired spacing. Test hole was fit on every pair of bolts. The center to center dimension which works is 530.5mm. Using a 24” Vernier the bolt to bolt spacing measured by screwing in a pair of M8 bolts in opposite holes and measuring the greatest distance between the heads of each bolt. The distances measured for two sets of holes was 21.381” and 21.385”. The bolt head a nominally 1/2” diameter head. To within small error the center to center spacing is then 21.381-0.5”. Which makes the measured spacing 530.377mm and 530.479mm. A test hole was made with the dimension 530mm and this did not fit nicely (might have been within the clearance hole tolerance). Using 530.5mm had the test piece fit nicely in every bolt pair.

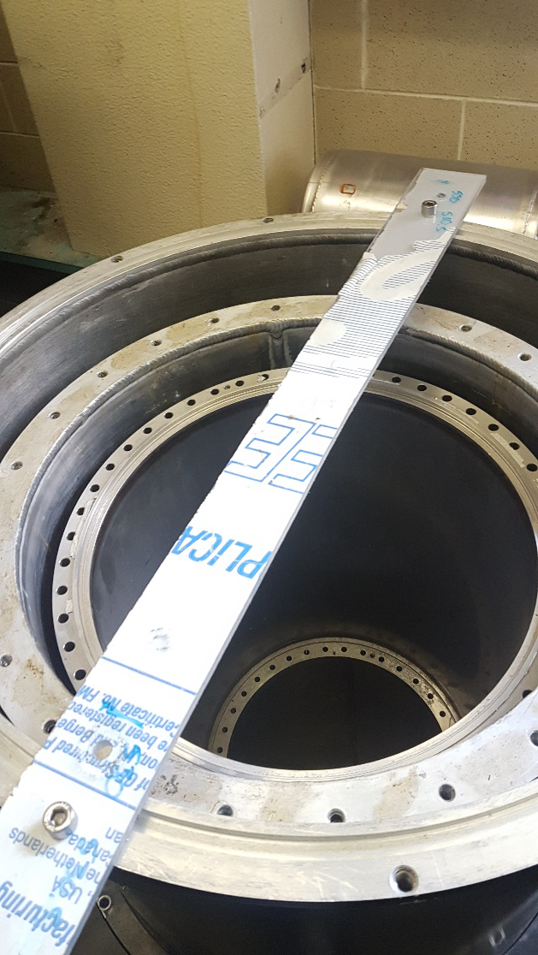
[picture p45: figure]

# Radiation Shield

The purpose of this is to reduce the radiated heat leak into the coldest part of the cryostat. (Pg.10 “Experimental techniques in condensed matter”). The first design question addressed was whether to use some pre-existing shields or to manufacture our own. We have decided to repurpose some shields which were laying around, whether this is the best option has not been fulled explored. Of primary concern is the weight of the shields, with secondary concern that they consume too much of the space in the cryostat.

Of the available pre-existing shields here are dimensions and weights:

Part | ID | OD (in) | Height (in) | Thickness (Thou) | Weight (lbs) | Material
55K top | 14.5 | 17 | 18.6875 | 186 | 22 | Al
55K bottom | 14.5 | 17 | 25.5 | 186 | 30 | Al
2.8K shield | 11.375 | 12.75 | 32 | ~<140 | 20 | Al
Vacuum shield short | ~19 | ~21.5 | ~19? | | 32 | Al
Vacuum shield long | ~19 | ~21.5 | ~40? | | 70 | Al

Also note that the radiation shields available are not the right height for this purpose. As a result they will have to be cut to length, which might be as much work as making custom shields.

For comparison the weights of the radiation shields in the D-wave Cryostat

Part | Wall Thickness (thou) | Weight (lbs)
55K Radiation shield (top) | | 6
55K Radiation shield (bottom) | | 15
2.8K Radiation shield | 66 | 13

*note that the thicknesses were estimated using a micrometer and a drill bit so the accuracy of the measurement isn’t excellent.

## Cooling Time Calculation

Using basic unit analysis to calculate how long it will take to cool a 22lb aluminum radiation shield:

coolingrate=40[W]=40[J/s](@45K)Alheatcapacity=921[J/(kgK)]heatcapacity=921*(22lbs)=921*9.97kg=9200[J/K]cooltime=9200/40*(300-45)K=59000[s]=16[hr]

This calculation is a good starting point but ignores the fact that heat capacity is a function of temperature which trends towards zero at low temperatures, meanwhile cooling rate is also temperature dependent, increasing with temperature. Thus this is a gross overestimate of the cooling time.

## PT415 cooling power

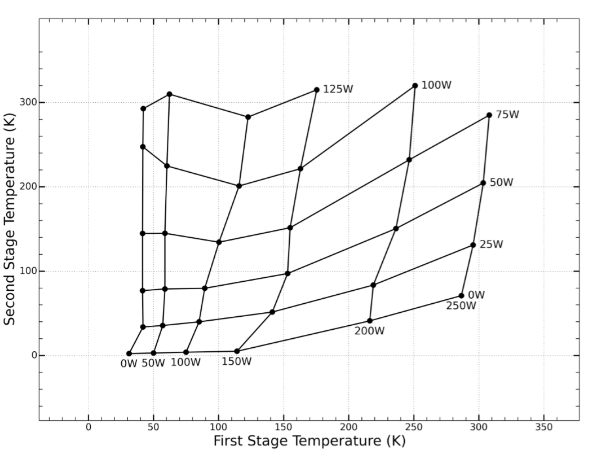
[picture p46: figure]

Looking at “Second stage cooling from a Cryomech PT415 cooler at second stage temperatures up to 300 K with cooling on the first-stage from 0 to 250 W” by green if the second stage is sufficiently cold then the first stage cooling power can be estimated as:

CoolingPower=15.65√(T-31.34)

## Heat Capacity

The heat capacity of a metal changes as a function of temperature. This can be a very complicate subject, luckily for temperatures above 10K the heat capacity in a metal is dominated by the phonon contribution which provides a simple model for the heat capacity.

C_(ph) =9R(T/(Θ_D))^3 ∫_0^(X_D) (x^4 e^x)/((e^x -1)^2)dx

Where R is the gas constant, T is the temperature Θ_D is the Debye temperature for the material, and X_D is equal to (Θ_D)/T . This equation can be numerically integrated fairly easily.

Comparing the numerical results to experimental results from “PROPERTIES OF SELECTED MATERIALS AT CRYOGENIC TEMPERATURES” by Peter E. Bradley and Ray Radebaugh shows a good agreement, especially for copper. For some reason there is a small offset in the aluminum data, it may be an error in the calculation not the theory.

## Total Cool Time

The next step is to combine the cooling power and heat capacity at temperature to determine the total cool time per kilogram. This will underestimate the cool time by some amount, partially due to the underestimation of cooling time in the theory seen in the heat capacity plot, and partially due to the fact that head conduction is also a function of temperature. The conducted heat is less at lower temperatures. With this as the low bound we will have bounded the cooling time between the gross overestimate above, and the (hopefully) mild underestimate here.

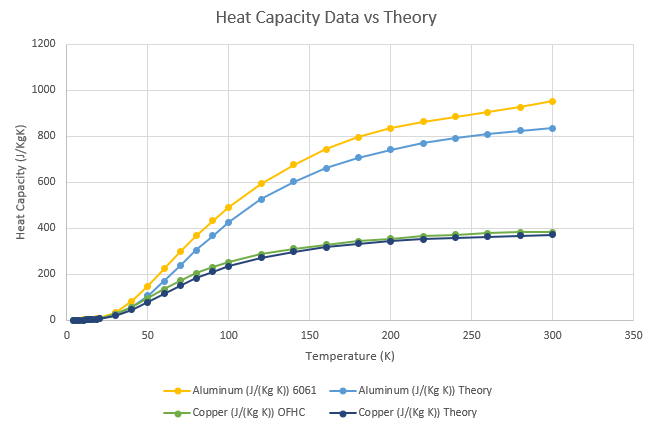
[picture p47: figure]

The cool time is given by:

t=∫_50^300 16√(T-31)(9R(T/(Θ_D))^3 )∫_0^((Θ_D)/T) (x^4 e^x)/((e^x -1)^2)dxdT =R144/((Θ_D )^3)∫_50^300 T^3 √(T-31)∫_0^((Θ_D)/T) (x^4 e^x)/((e^x -1)^2)dxdT

Doing this math gives a lower bound on the cool time as:

Material | Time (min/Kg) | Time (min/L)
Aluminum | 14.2 | 38.4
Copper | 7.08 | 63.4

Which puts the cool time of 50lbs of 55K shield at around 5hrs. Conversely if the 55K shield can be brought down to a space age weight of 15lbs the cool time would be 100min. The results are summarized in the plot below. The way to read the figure is pick a desired end temperature for the 55K stage, then the plot tells you how long it takes to reach that temperature.


## Thermal Conduction

The next correction needed is the decrease in cooling rate due to a finite thermal conduction. That is to say it takes some amount of time for the heat stored at the bottom of the design to reach the PT cooler. This could potentially be a lot of time. Thermal conduction is again a parameter which is affected by temperature, however in contrast to heat capacity, the thermal conduction gets worse as the temperature decreases.

Another factor that needs to be investigated is transferring the heat from the various stages to the PT cooler. Existing cryostats have a fexible copper braid to transfer the heat, this allows the vibrations from the PT cooler to be decoupled from the experimental stages. Also differential thermal expansion is compensated for by using the braided cable.

The existing cable from the manufacturer looks like the picture bellow and is very expensive to purchase from the manufacturer. A local welding company, Grand Valley Weld, has confirm that they can weld copper and this might be a route for achieving the fit and finish seen in the photos. However a question arises in whether it’s necessary to weld the copper or if it’s acceptable to just crimp the cables.

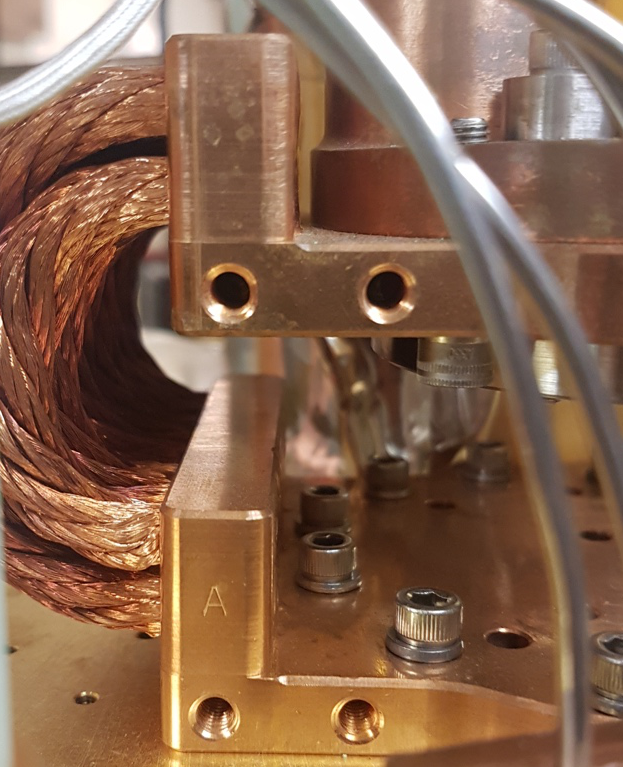
[picture p48: figure]
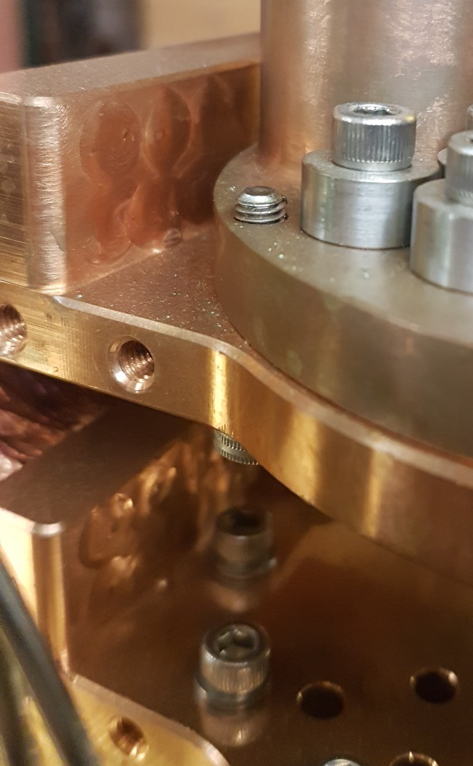
[picture p49: figure]

Since the thermal conductivity is proportional to the electrical conductivity the simplest way to go about figuring out whether crimping is good enough is to measure the electrical resistance of this joint. Since we’re talking about the resistance of a copper connection normally thought of as a perfect conductor we’ll need to use the 4-wire method.

### 4-Wire Method

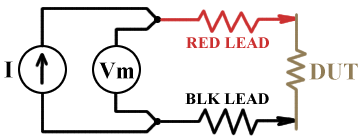
[picture p50: figure]

A conventional 2-wire resistance measurement uses a single pair of leads through which the multimeter drives a known current and measures the resulting voltage across the element of interest. As shown in the picture to the left, a multimeter will internally have a current source and a volt meter. The current will go through the lead resistance, and the contact resistance of the probes and the voltage will measure the voltage drop across all of this.

V=IR =I(R_(lead) +R_(DUT) +R_(lead) ) =2IR_(lead) +IR_(DUT) limR_(lead) ≪R_(DUT) →IR_(DUT)

The problem arises when the lead and contact resistance is not much smaller than the device under test (DUT) resistance. In this case the reading is no longer accurate. This is where the 4-wire measurement comes into play.

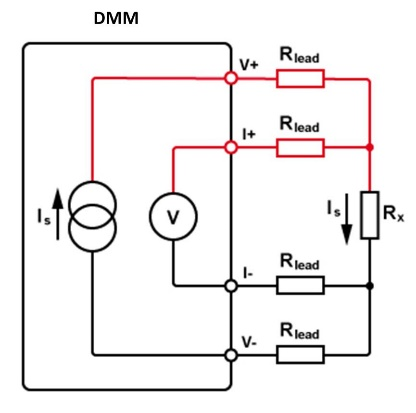
[picture p51: figure]

In the 4-wire the current source is separated from the voltage reading. The reason this eliminates contact resistance issues can be illuminated applying Kirchhoff’s rules for voltage and current. Namely that the voltage drop around a loop is zero, and that the sum of currents at each junction is zero:

∑_k V_k =0 , ∑_k I_k =0

Looking at the junction going into the positive lead of the multimeter (where R_load, Rx, and Is meet). The current law looks like:

∑_k I_k =I_s -I_m -I_x =0 I_s =(V_m)/(R_m)+(V_x)/(R_x)

Note that the resistance of the multimeter is typically 1Mohm. With the actual resistance including contact resistance and lead resistance given by:

R_m =R_(contact) +R_(lead) +R_(multimeter) +R_(lead) +R_(contact)

But the contact and lead resistances are typically on the order of 1ohm, while the internal resistance is orders of magnitude larger. Thus:

R_m ≅R_(multimeter) =10MΩ

Thus we have effectively removed the influence of the contact resistance in the voltage measurement. Now to move forward with the current loop we need to know the voltages, using kirchoff’s voltage law we get:

∑_k V_k =V_m -V_x =0 V_m =V_x =V

Thus:

I_s =V/(R_m)+V/(R_x)≅V/(R_x)

Which states that we can find the resistance value of interest knowing the voltage across the resistor and the current from the current source. Also note that the lead resistance of the current source doesn’t matter because the current law says that the current in is the current out of a junction, and all we care about is the current at the resistor of interest.

## Appendix: weights and dimensions of things

Part | ID | OD (in) | Height (in) | Thickness (Thou) | Weight (lbs) | Material
55K top | 14.5 | 17 | 18.6875 | 186 | 22 | Al
55K bottom | 14.5 | 17 | 25.5 | 186 | 30 | Al
2.8K shield (long foil covered shield) | 11.375 | 12.75 | 32 | ~<140 | 20 | Al
Vacuum shield short | ~19 | ~21.5 | ~19? | | 32 | Al
Vacuum shield long | ~19 | ~21.5 | ~40? | | 70 | Al

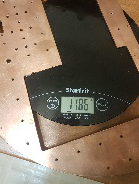
[picture p52: figure]

Copper scrap | 13 | | 1/8 | | 2.6 | Cu

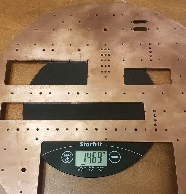
[picture p53: figure]

Copper scrap 2 | 13 | | 1/8 | | 3.2 | Cu
Copper weight | | | | | 35 | Cu
Lead weight | | | | | 25 | Pb
Lead weight 2 | | | | | 30 | Pb

Projected weights using CAD software

Part | Weight (lbs) | Material
55K shield | 0.75 | Aluminum
Self rolled 55K shield
