nikolayvidenov/Cryorefrigerator/ReportB/Figures/CalibrationErrorAll.png

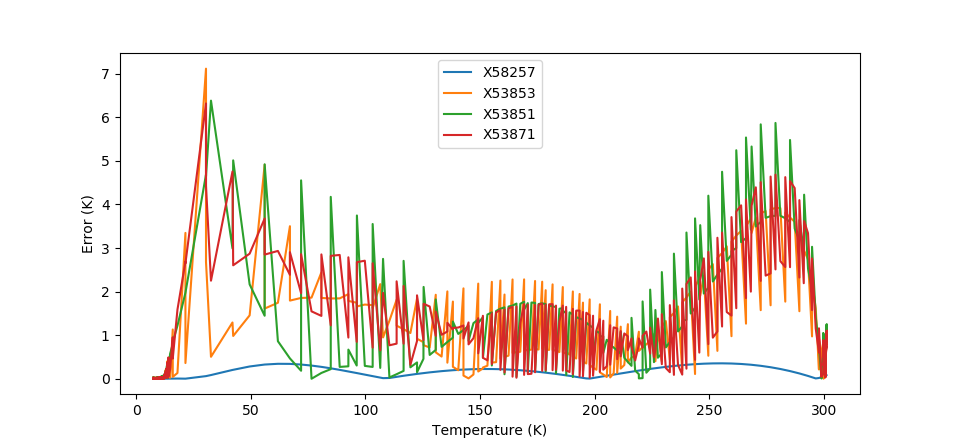
ReportB/Figures/CalibrationErrorAll.png
