nikolayvidenov/Cryorefrigerator/ReportB/Figures/CalibrationErrorLow.png

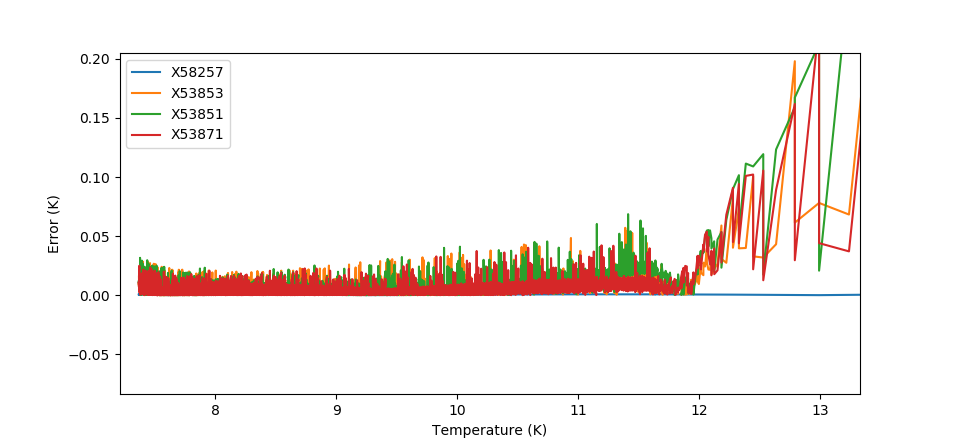
ReportB/Figures/CalibrationErrorLow.png
