nikolayvidenov/Cryorefrigerator/ReportB/Figures/CalibrationResistanceTime.png

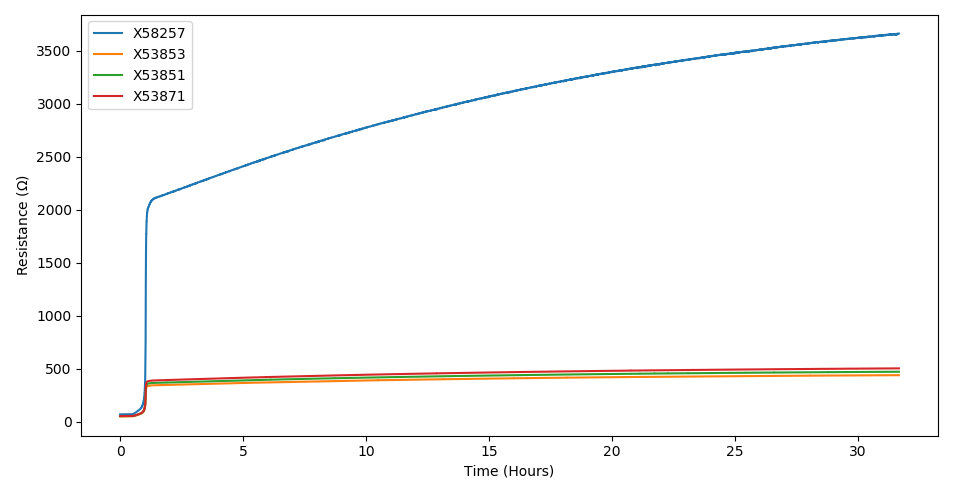
ReportB/Figures/CalibrationResistanceTime.png
