nikolayvidenov/Cryorefrigerator/ReportB/Figures/CalibrationTemperatureTemperature.png

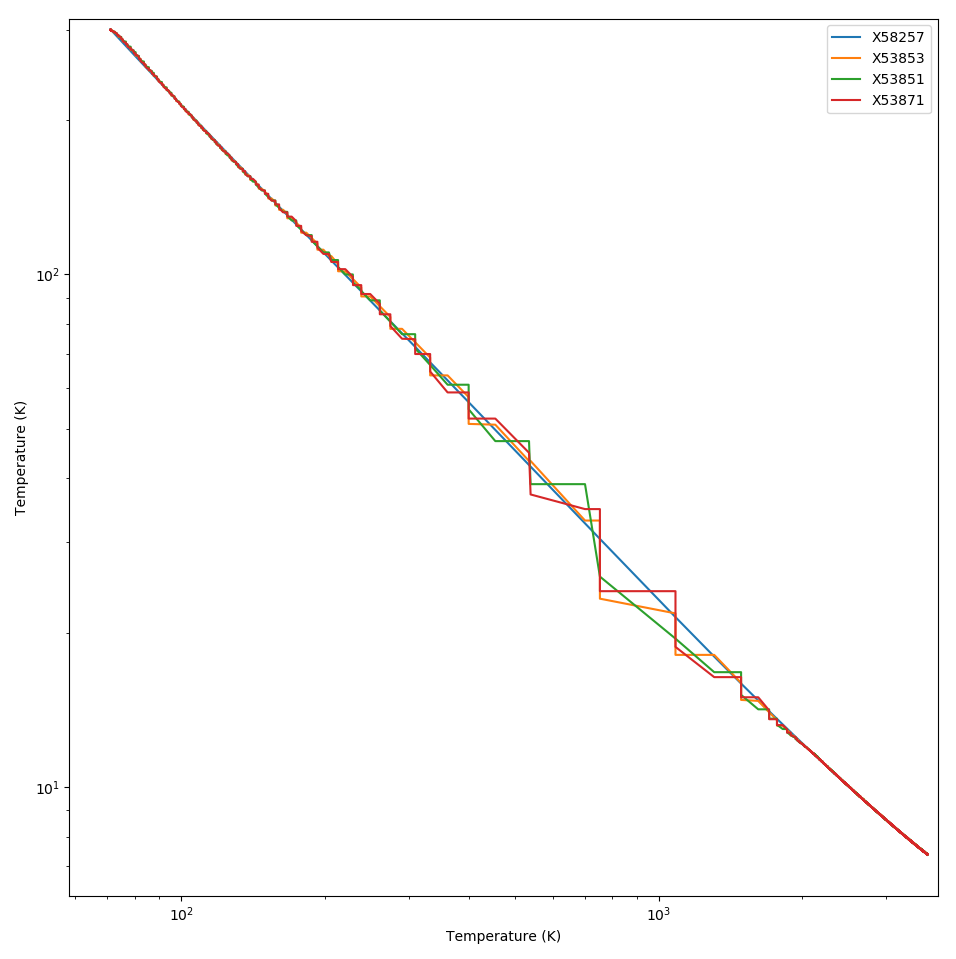
ReportB/Figures/CalibrationTemperatureTemperature.png
