nikolayvidenov/Cryorefrigerator/ReportB/Figures/CalibrationTemperatureTime.png

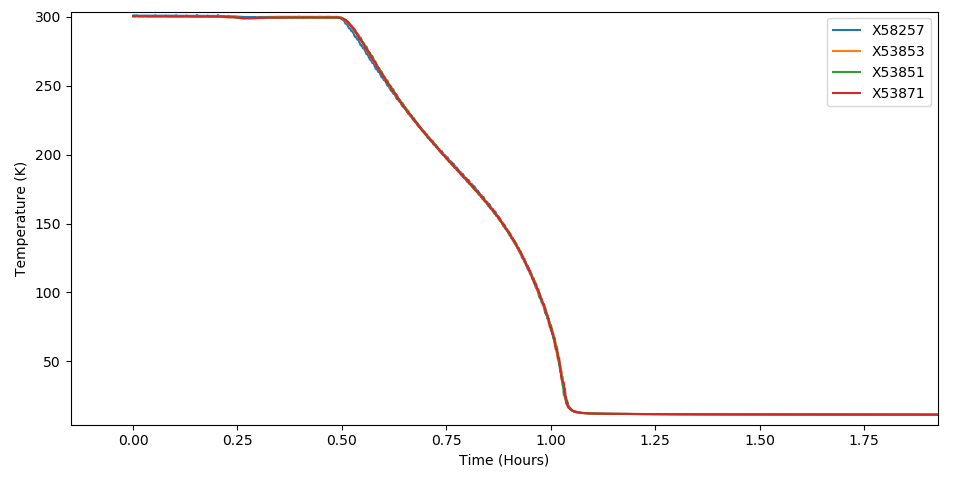
ReportB/Figures/CalibrationTemperatureTime.png
