nikolayvidenov/Cryorefrigerator/CAD/Top Plate V2 mounting holes.pdf

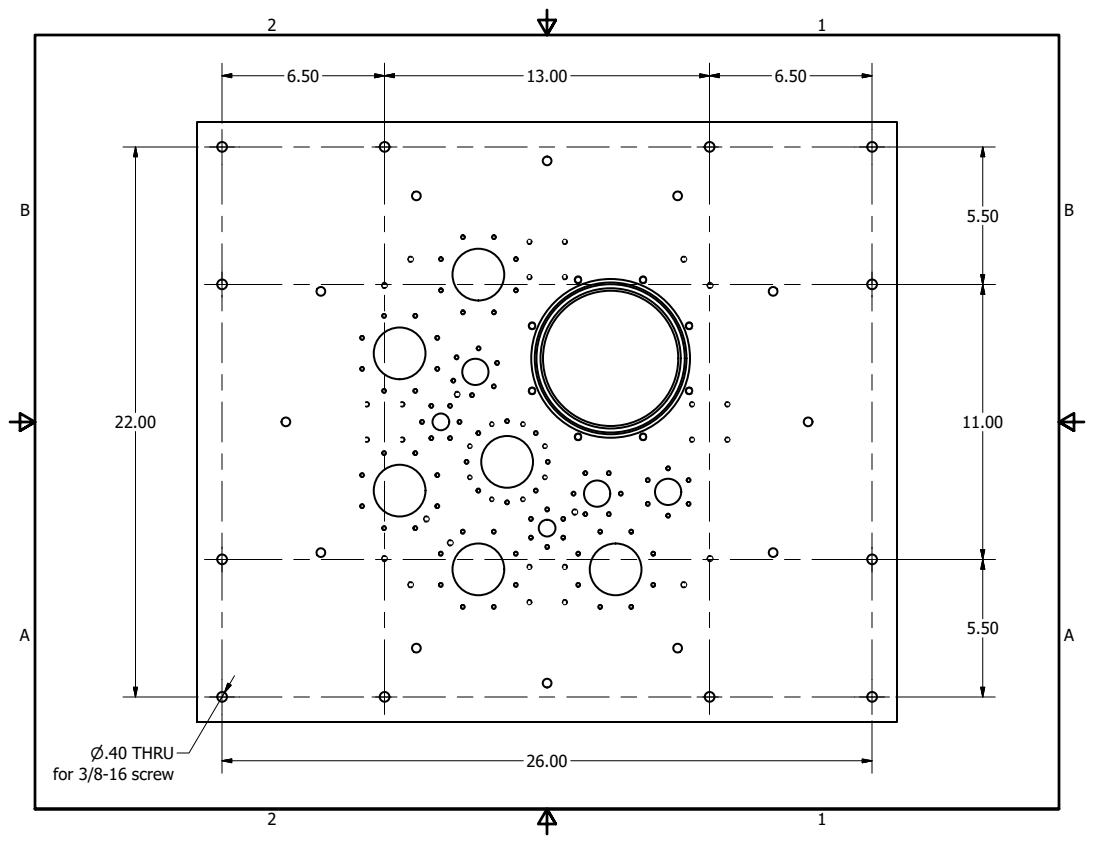
[picture p59: page 1]
for 3/8-16 screw
