nikolayvidenov/Cryorefrigerator/CAD/Top Plate PT415 grooves.pdf

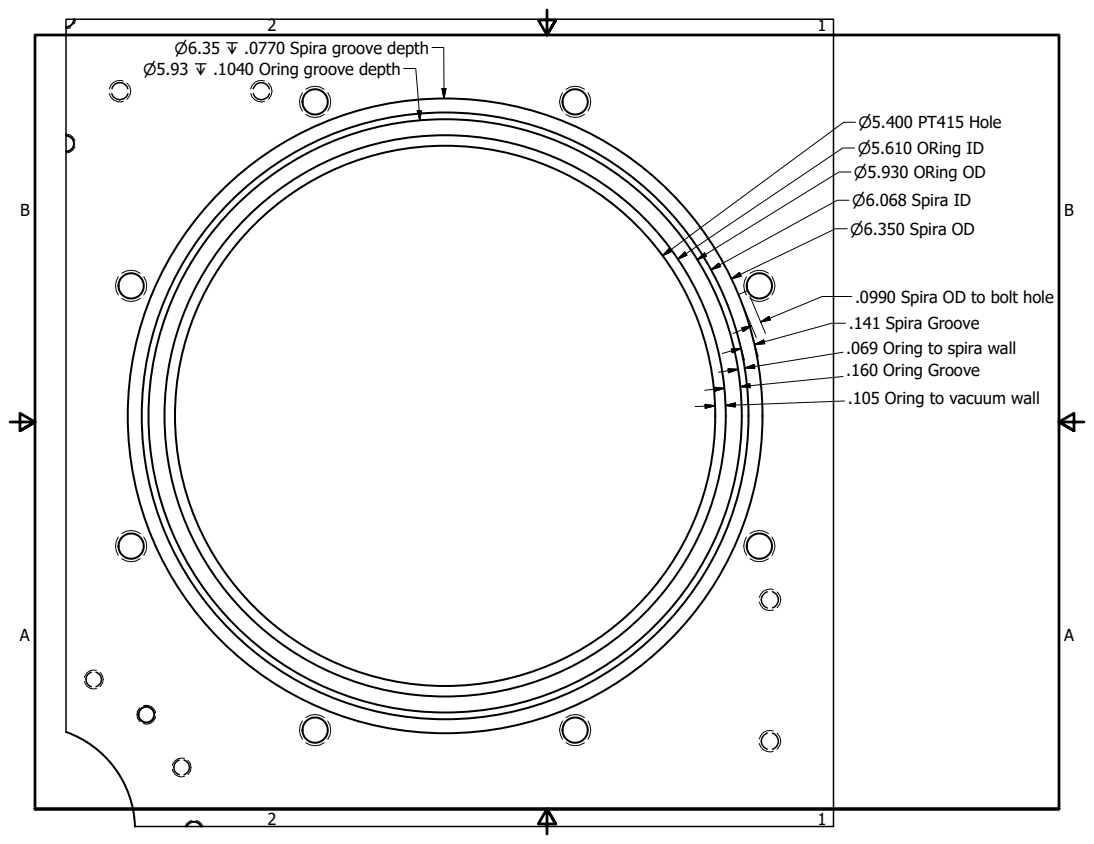
[picture p60: page 1]

6.35  .0770 Spira groove depth
5.93  .1040 Oring groove depth

.0990 Spira OD to bolt hole
.141 Spira Groove
.069 Oring to spira wall
.160 Oring Groove
.105 Oring to vacuum wall
