nikolayvidenov/Cryorefrigerator/CAD/Top Plate Dimentions.pdf

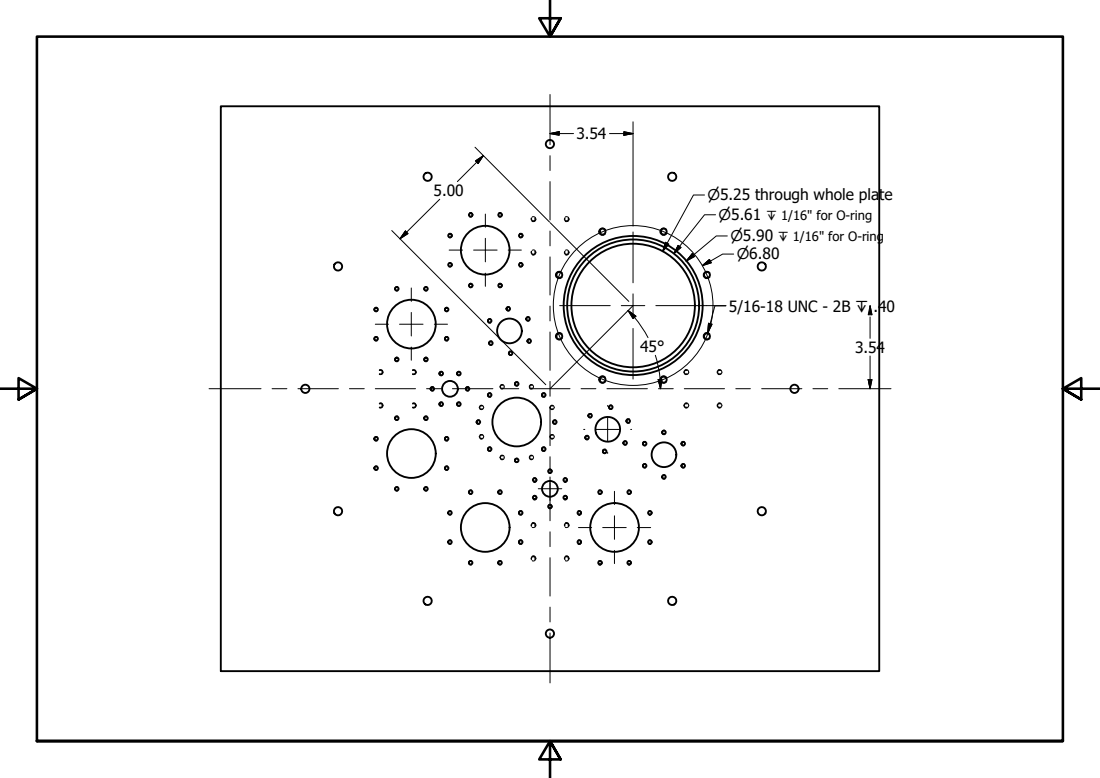
[picture p61: page 1]

5.25 through whole plate
5.61  1/16" for O-ring
5.90  1/16" for O-ring
