nikolayvidenov/Cryorefrigerator/CAD/adapter.pdf

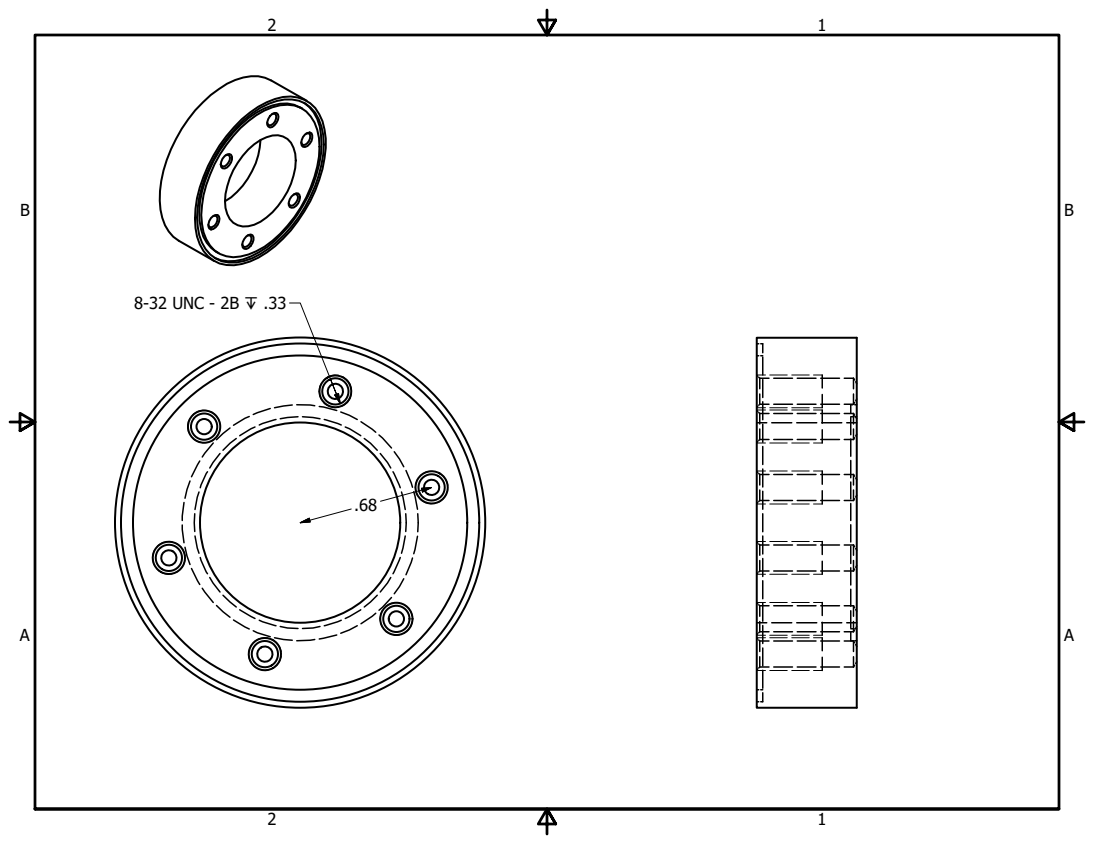
[picture p62: page 1]
