nikolayvidenov/Cryorefrigerator/CAD/brassbushing2.pdf

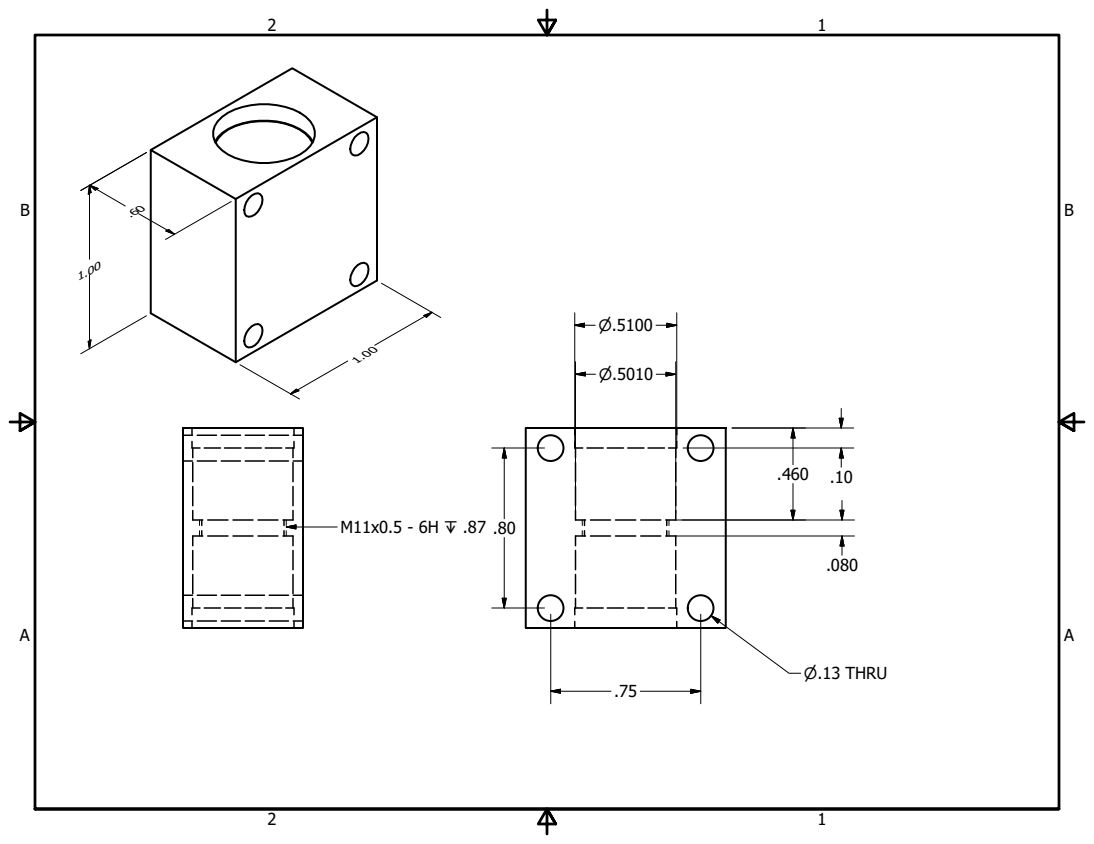
[picture p63: page 1]
