nikolayvidenov/Cryorefrigerator/CAD/fridge bushing.pdf

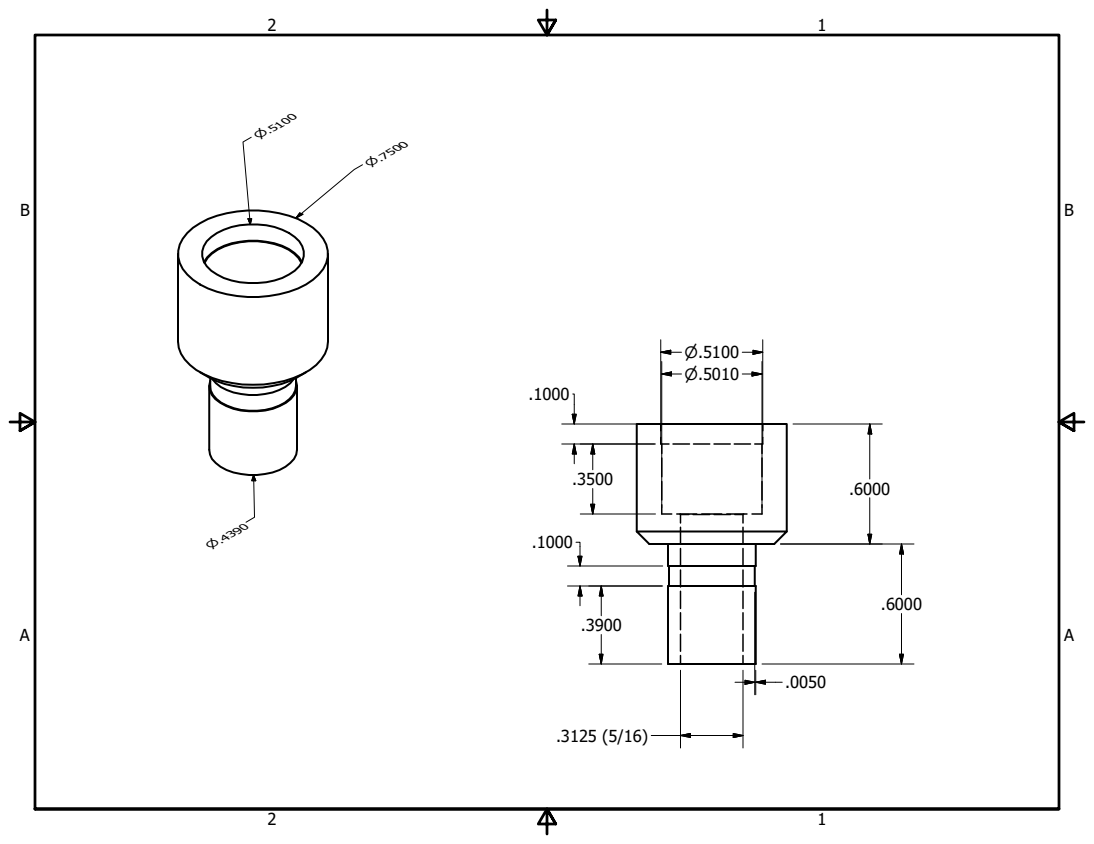
[picture p64: page 1]
