nikolayvidenov/Cryorefrigerator/CAD/heatsink.pdf

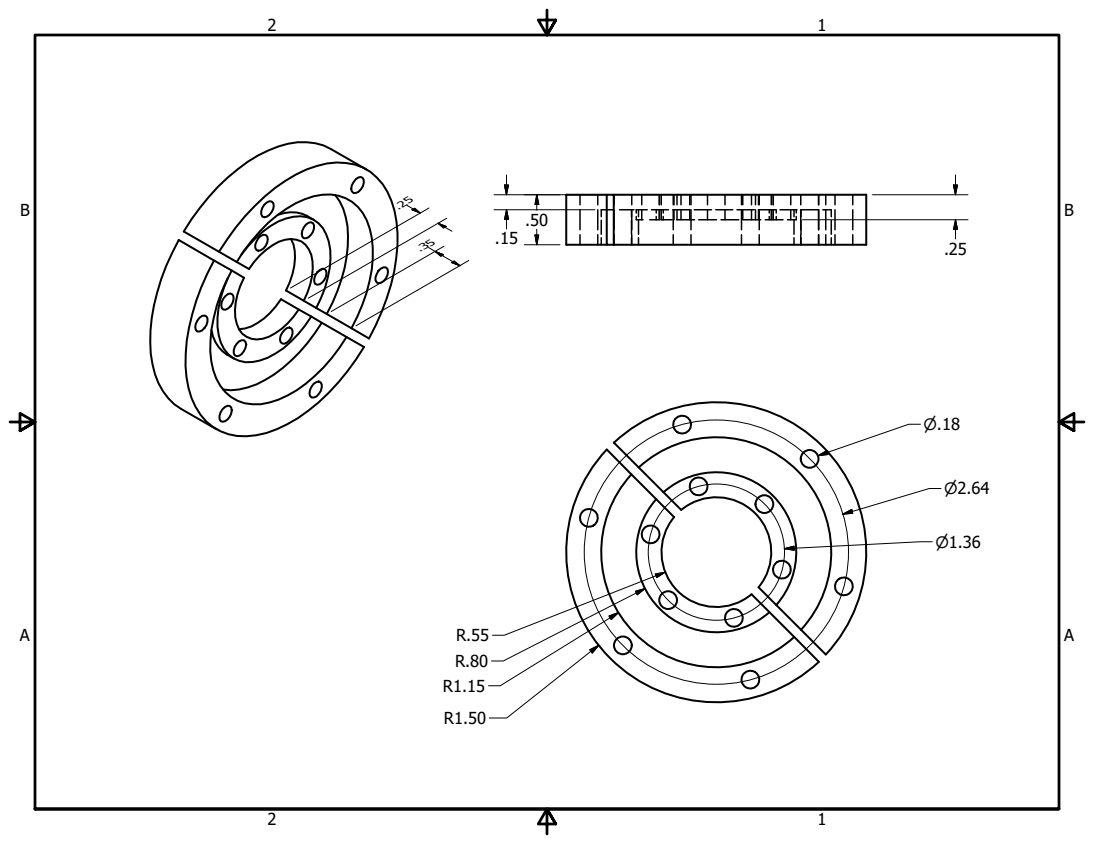
[picture p65: page 1]
