nikolayvidenov/Cryorefrigerator/CAD/mount.pdf

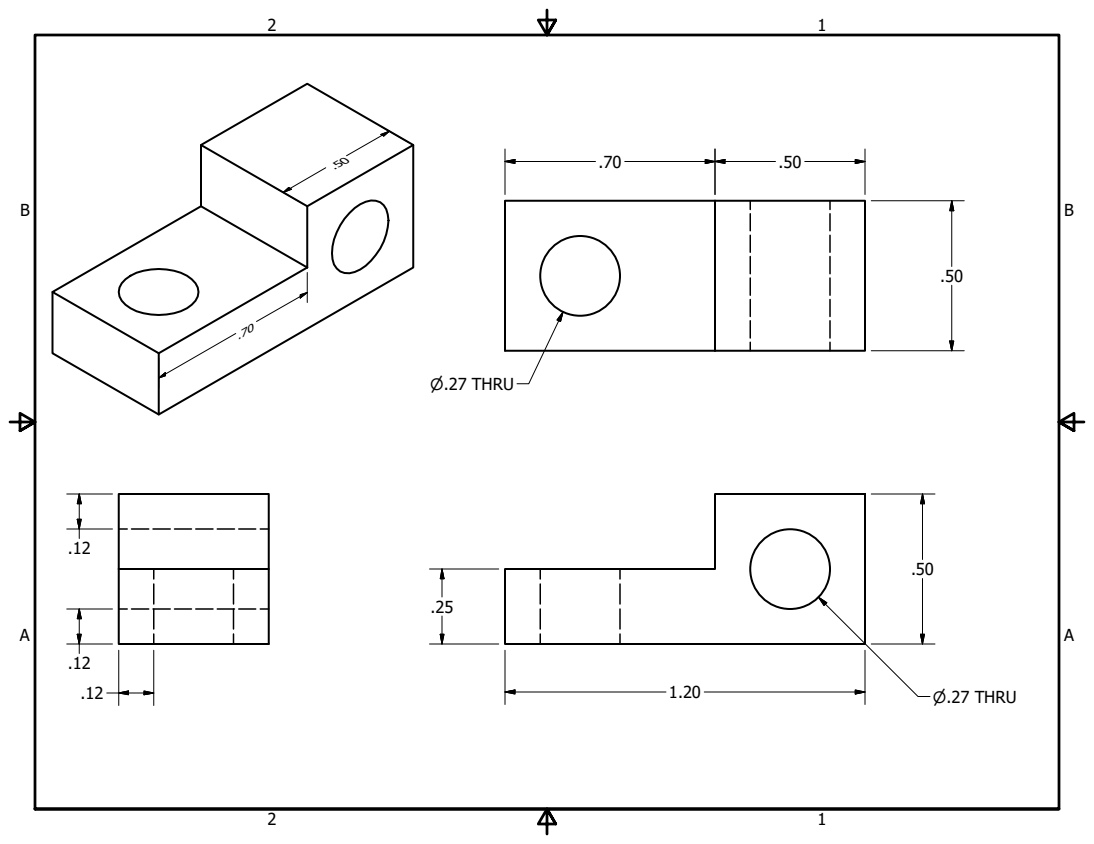
[picture p66: page 1]
