nikolayvidenov/Cryorefrigerator/CAD/still pipe.pdf

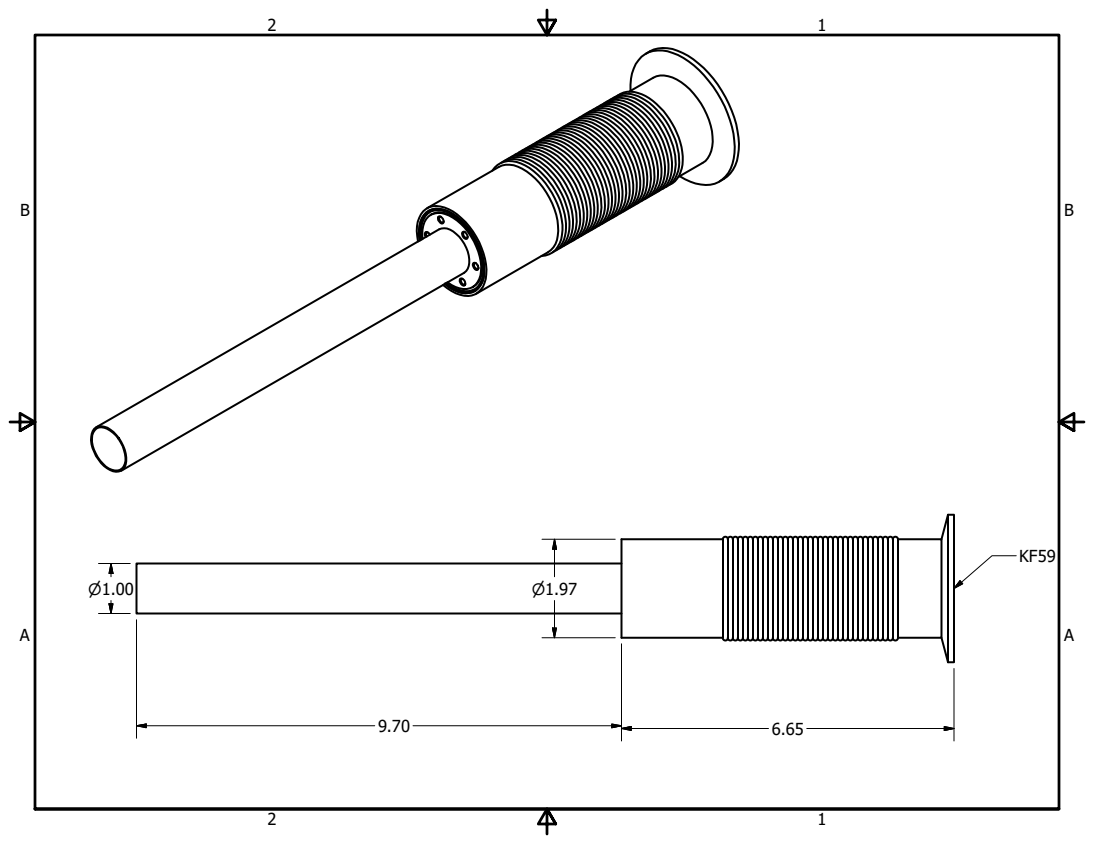
[picture p67: page 1]
