nikolayvidenov/Cryorefrigerator/CAD/universal connector male.pdf

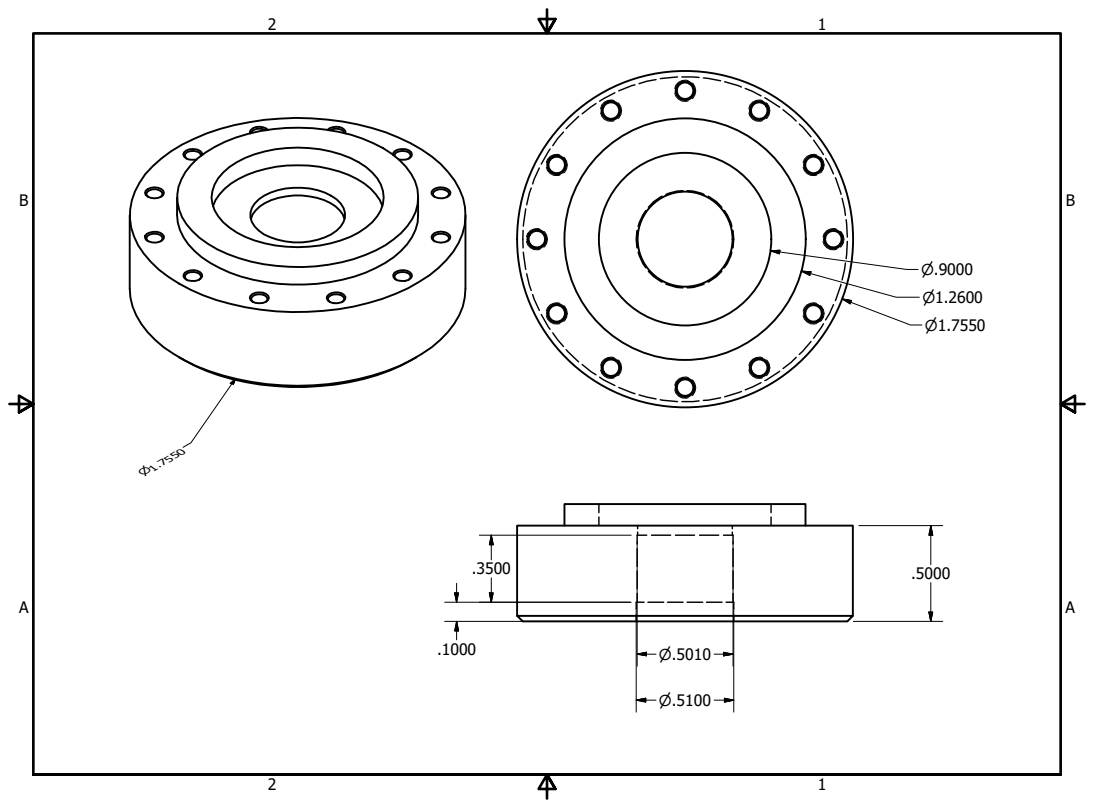
[picture p68: page 1]
