nikolayvidenov/Cryorefrigerator/CAD/feet type 3 part 1.pdf

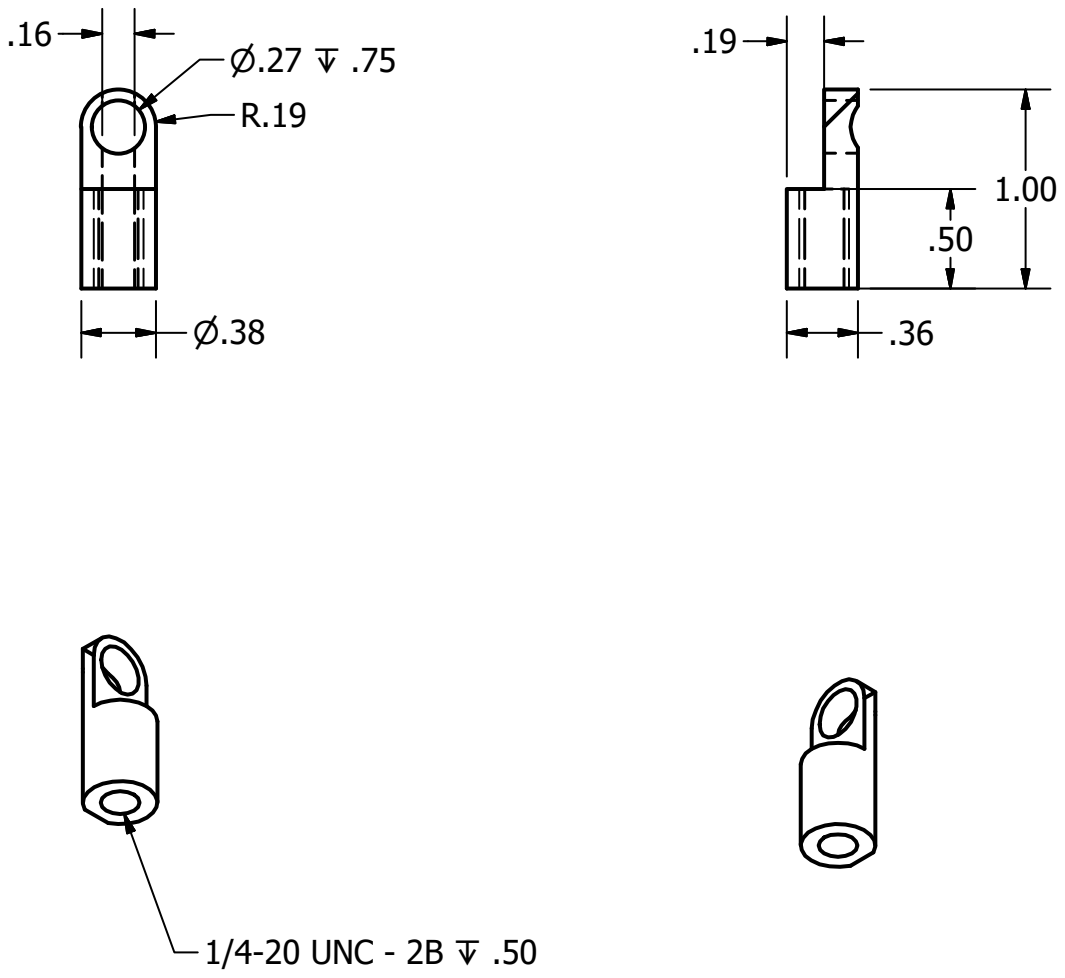
[picture p69: page 1]
