nikolayvidenov/Cryorefrigerator/CAD/feet type 3 part 2.pdf

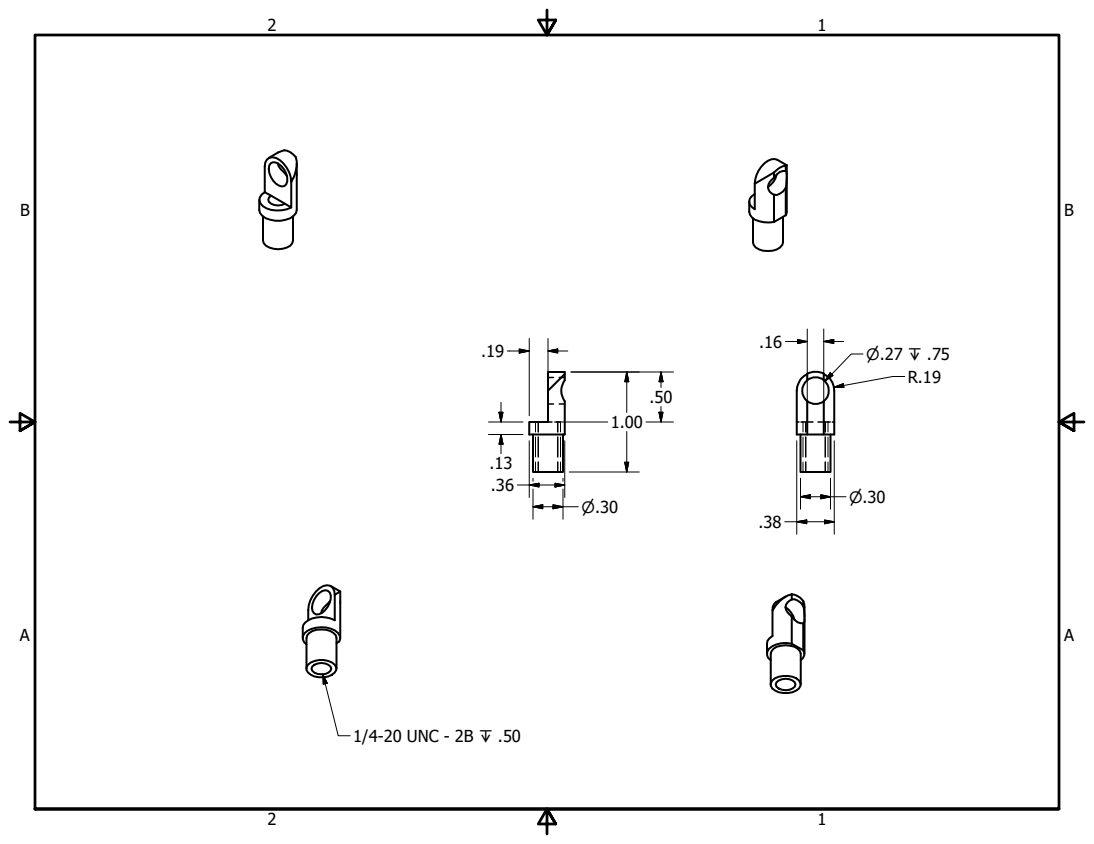
[picture p70: page 1]
