nikolayvidenov/Cryorefrigerator/CAD/Top Plate V2 PT415 moved in.pdf

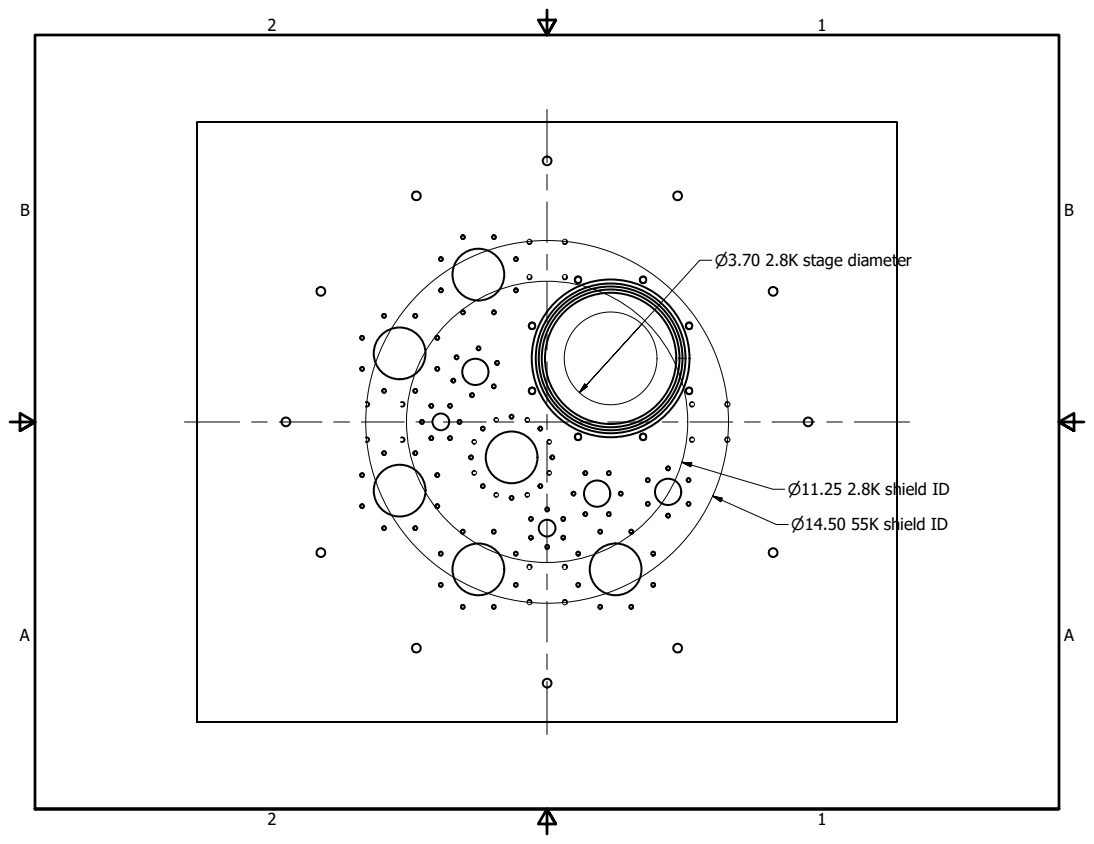
[picture p71: page 1]
