nikolayvidenov/Cryorefrigerator/CAD/large spira config.pdf

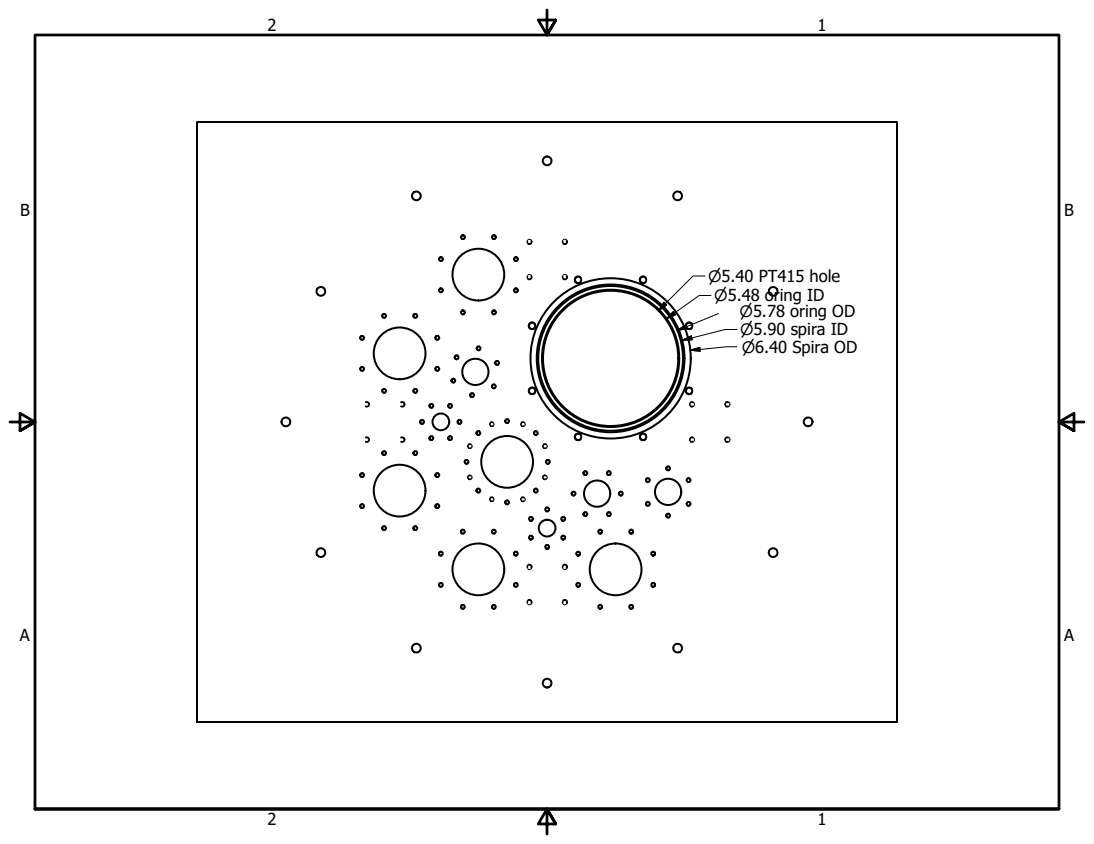
[picture p72: page 1]
