nikolayvidenov/Cryorefrigerator/CAD/small spira config.pdf

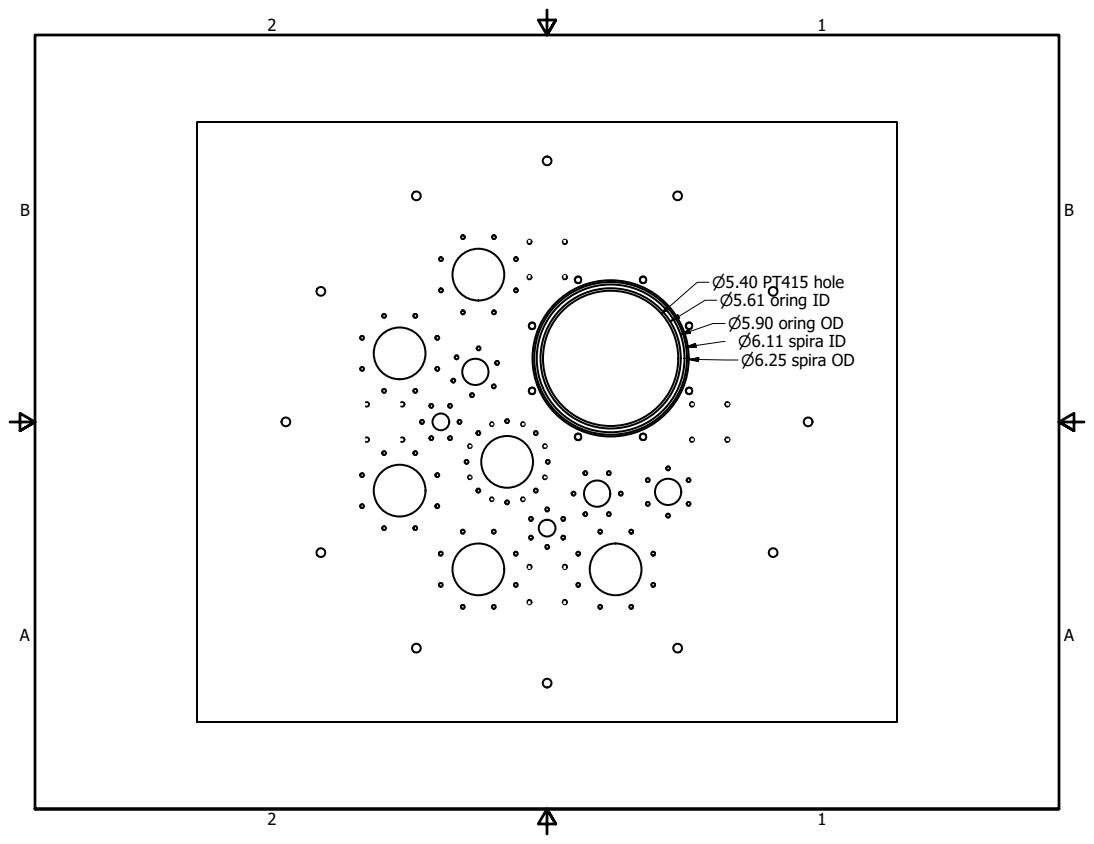
[picture p73: page 1]
