nikolayvidenov/Cryorefrigerator/CAD/Top Plate V2.pdf

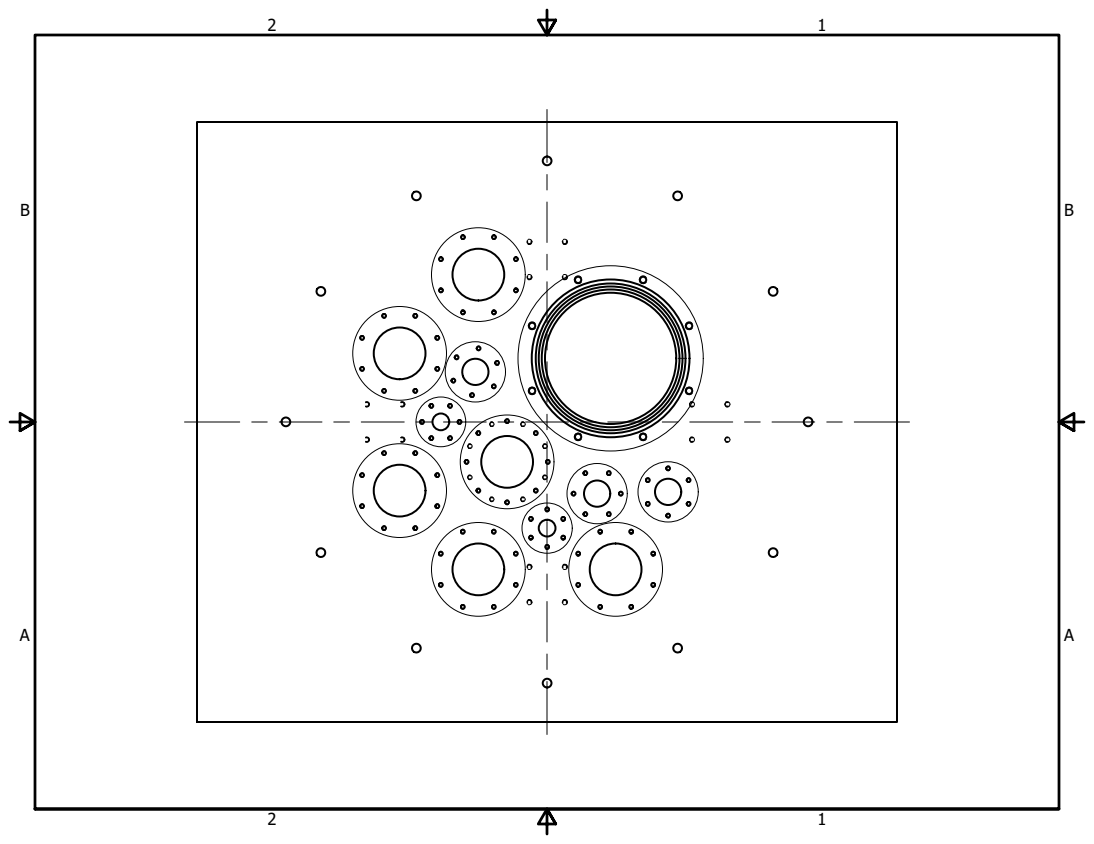
[picture p74: page 1]
