nikolayvidenov/Cryorefrigerator/CAD/Top Plate Dimentions KF16.pdf

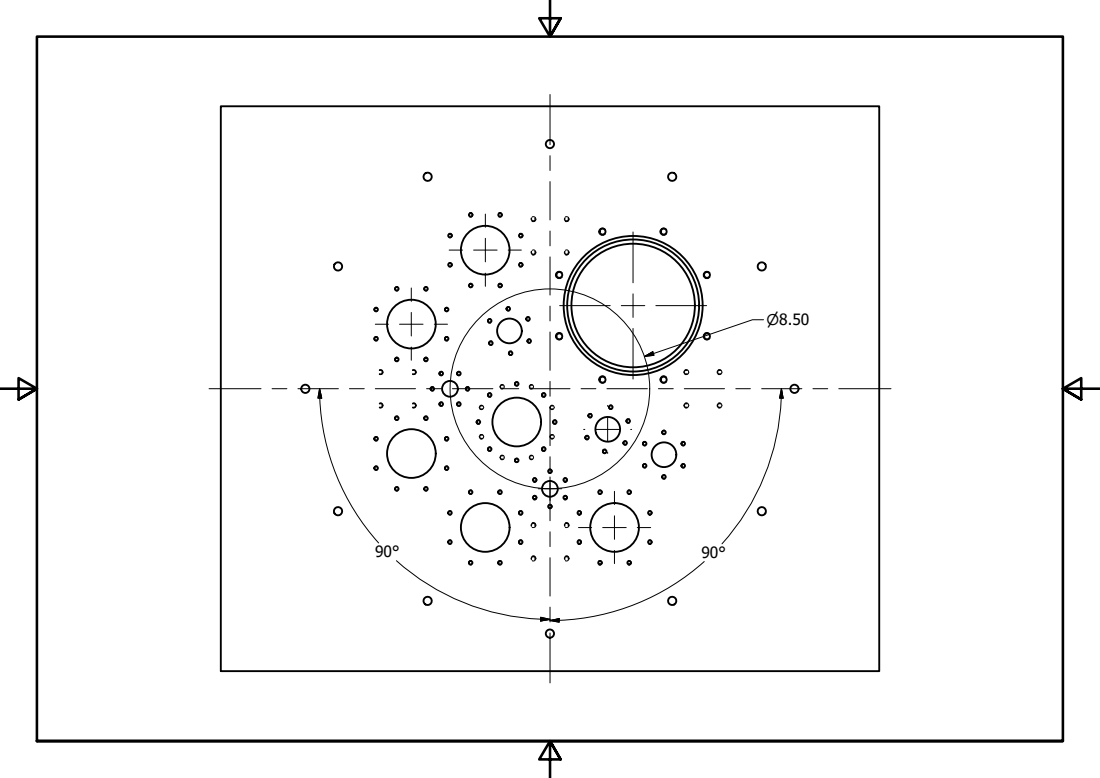
[picture p75: page 1]
