nikolayvidenov/Cryorefrigerator/CAD/Top Plate Dimentions KF25.pdf

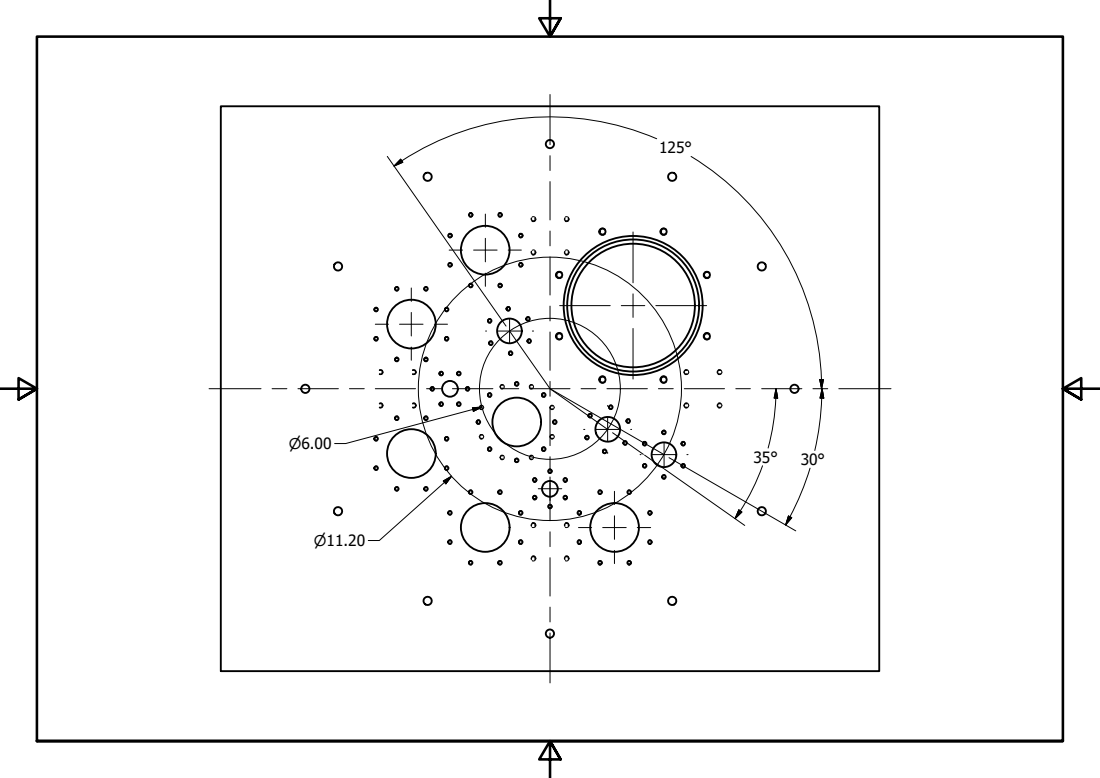
[picture p76: page 1]
