nikolayvidenov/Cryorefrigerator/CAD/Top Plate Dimentions KF50.pdf

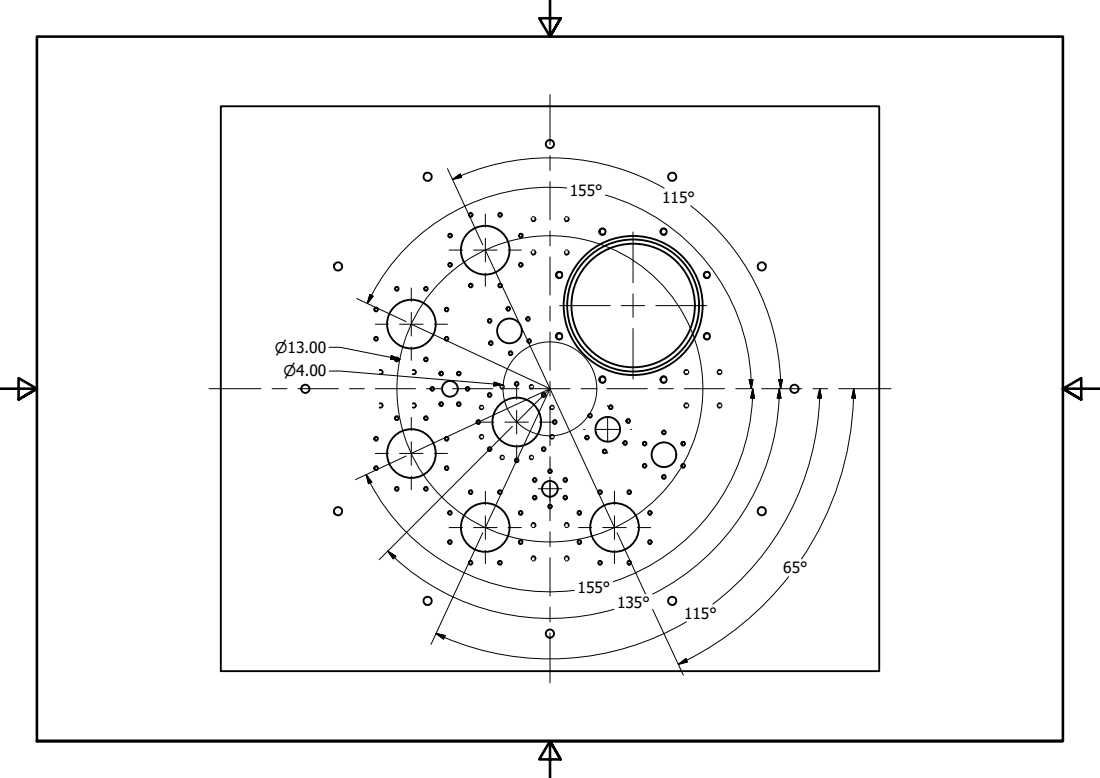
[picture p77: page 1]
