nikolayvidenov/Cryorefrigerator/CAD/Top Plate Simple.pdf

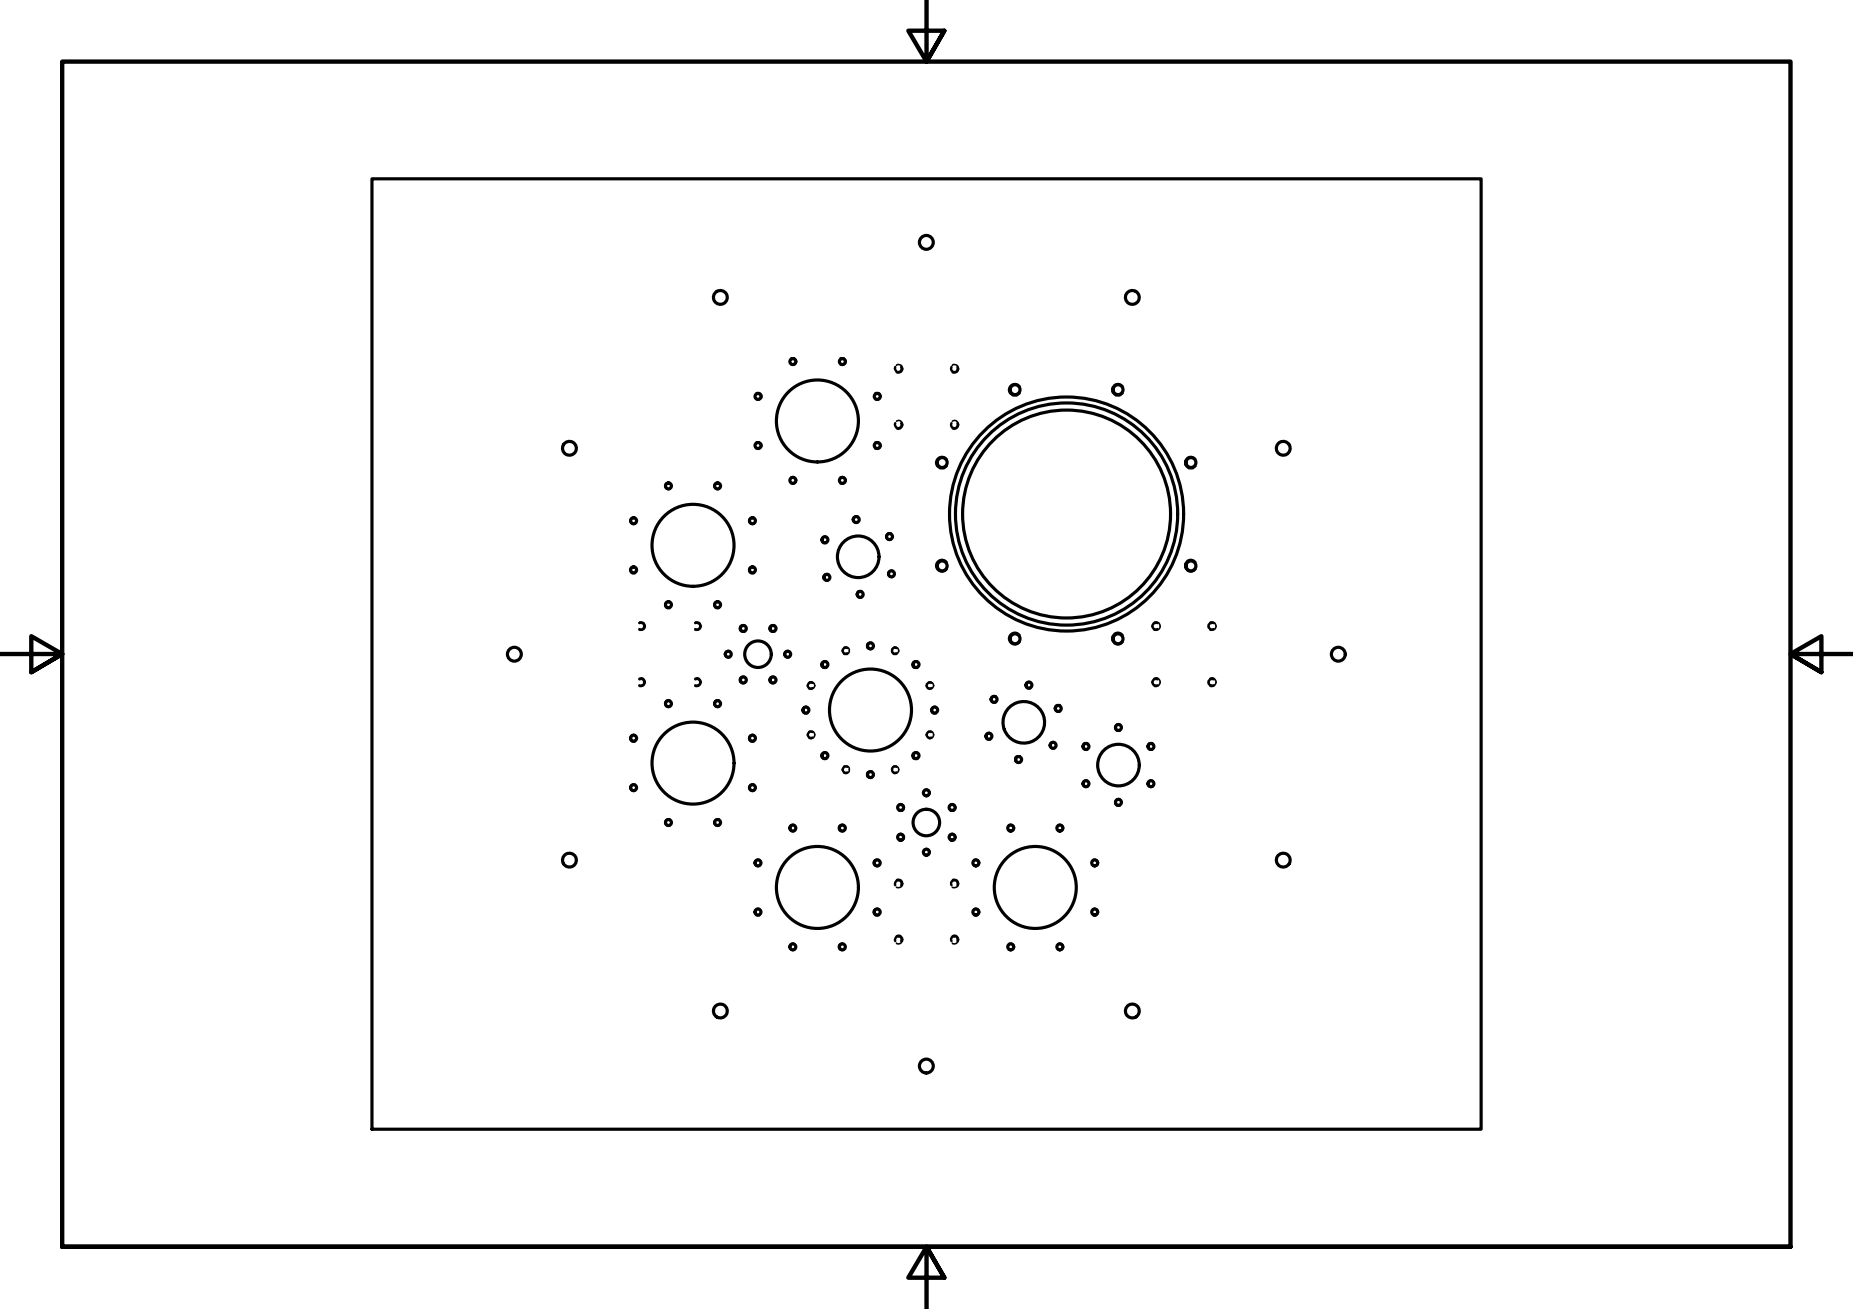
[picture p78: page 1]
