nikolayvidenov/Cryorefrigerator/CAD/Top Plate V1.pdf

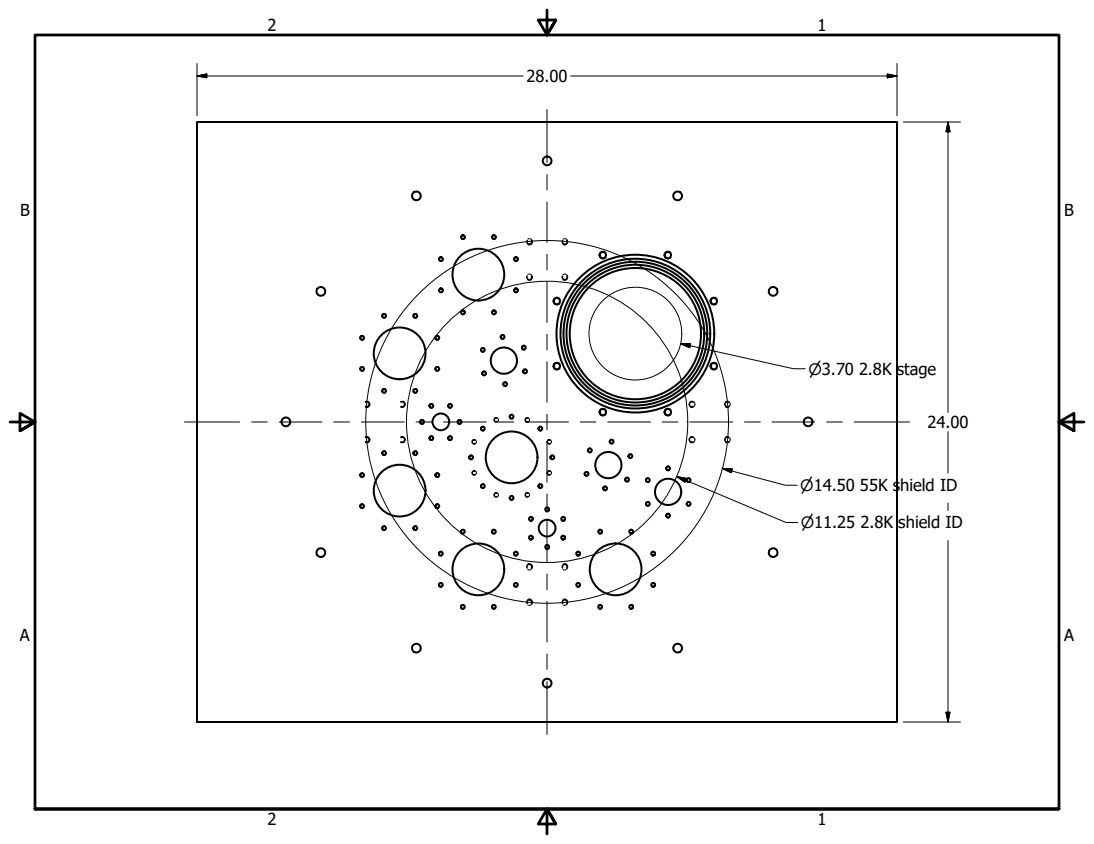
[picture p79: page 1]
