nikolayvidenov/Cryorefrigerator/(commit log)

2018-08-07 Inital file setup, and first draft of top plate. Also we started documentation
    [Top Plate.0001.ipt, Top Plate.ipt]
2018-08-09 Got a CAD Model for the PT415 from the manufacturer
    [CH40415 24JUL14 C.stp]
2018-08-09 Added some color to the Cryomech step file
    [Cryostat top plate.iam]
2018-08-22 colorized the PT415, added a bunch of KF fillange bolt patternes in the top plate
    [CH40415 24JUL14 C.0003.ipt, CH40415 24JUL14 C.ipt, Cryostat top plate.0001.iam, Cryostat top plate.iam, Top Plate.0001.ipt, Top Plate.0003.ipt, Top Plate.ipt, qf25-100-bc.stp]
2018-09-08 Completed first draft of mounting plate, also some basic stress analysis of said plate
    [Cryostat top plate.0001.iam, Cryostat top plate.0003.iam, Cryostat top plate.iam, QF16-075-BC.ipt, QF25-100-BC.ipt, SOCKET HEAD CAP SCREW #10-32.0001.ipt, SOCKET HEAD CAP SCREW #10-32.ipt, Top Plate.0003.ipt]
2018-09-12 bolts for plate are now M8 clearance
    [Cryostat top plate.0003.iam, Cryostat top plate.0004.iam, Cryostat top plate.iam, Top Plate.0011.ipt, Top Plate.0014.ipt, Top Plate.ipt]
2018-09-12 changed the bolt to M8 on the vacuum jacket
    [vacuum jacket long.0003.ipt, vacuum jacket long.0004.ipt, vacuum jacket long.ipt]
2018-09-15 modified the cad
    [Top Plate Dimentions KF16.0002.dwg, Top Plate Dimentions KF16.dwg, Top Plate Dimentions KF25.0002.dwg, Top Plate Dimentions KF25.dwg, Top Plate Dimentions KF50.0002.dwg, Top Plate Dimentions KF50.dwg, Top Plate Dimentions.0004.dwg, Top Plate Dimentions.dwg]
2018-09-20 changed the KF holes to not have the lip for the centering rings
    [Top Plate.0024.ipt, Top Plate.0025.ipt, Top Plate.ipt]
2018-09-21 changed srtuff
    [Top Plate Dimentions KF16.0002.dwg, Top Plate Dimentions KF16.0003.dwg, Top Plate Dimentions KF16.dwg, Top Plate Dimentions KF25.0002.dwg, Top Plate Dimentions KF25.0003.dwg, Top Plate Dimentions KF25.dwg, Top Plate Dimentions KF50.0002.dwg, Top Plate Dimentions KF50.0003.dwg]
2018-09-24 Documneted bolt pattern for vacuum jacket. Also modified the CAD, added a second o-ring groove with emi sheilding
    [Top Plate.0027.ipt, Top Plate.0029.ipt, Top Plate.ipt]
2018-10-10 first version with no modifications
    [Cryostat top plate.0004.iam, Cryostat top plate.0005.iam, Cryostat top plate.iam, Top Plate.0029.ipt, Top Plate.0030.ipt, Top Plate.ipt]
2018-10-10 adjusted so that radiation shields fit properly, added some documentation, also we have the recommended land pattern from cryomech
    [Cryostat top plate.0005.iam, Cryostat top plate.0006.iam, Cryostat top plate.iam, Radiation Sheild 55K.ipt, Top Plate V2.0001.ipt, Top Plate V2.ipt, Top Plate V3.ipt, Top Plate.0030.ipt]
2018-10-10 moved a KF fillang, documentaion
    [Cryostat top plate.0005.iam, Cryostat.0001.iam, Cryostat.iam, QF50-200-BC.ipt, Radiation Sheild 2K.ipt, Radiation Sheild 55K bottom.ipt, SOCKET HEAD CAP SCREW #10-32.0002.ipt, SOCKET HEAD CAP SCREW #10-32.ipt]
2018-10-10 spira oring thing
    [Cryostat.0001.iam, Cryostat.0002.iam, Cryostat.iam, Top Plate V2.0003.ipt, Top Plate V2.0004.ipt, Top Plate V2.ipt]
2018-10-11 Oring and spira groove settled
    [Top Plate V2.0004.ipt, Top Plate V2.0005.ipt, Top Plate V2.ipt, Top Plate V3.ipt, Top Plate.ipt]
2018-10-11 added two choices for spira
    [Top Plate V2 oring.dwg, Top Plate V2.2.dwg, Top Plate V2.2.ipt]
2018-10-12 added articles
    [Cryostat.0002.iam, Cryostat.0003.iam, Cryostat.iam, Top Plate V2.0005.ipt, Top Plate V2.0006.ipt, Top Plate V2.2.ipt, Top Plate V2.ipt]
2018-10-14 CAD and further cooling calculations
    [2K8 stage.0002.ipt, 2K8 stage.ipt, 55K shield sheet.0001.ipt, 55K shield sheet.ipt, 55K stage.0015.ipt, 55K stage.ipt, Cryostat.0003.iam, Cryostat.0007.iam]
2018-10-16 Added feet and new feet holes
    [55K mini shield.0001.ipt, 55K mini shield.ipt, Cryostat.0008.iam, Cryostat.0010.iam, Cryostat.iam, Stiffness Analysis.iam, Top Plate V2.2.0008.ipt, Top Plate V2.2.0019.ipt]
2018-10-18 added mounting holes, and made a CAD table
    [Top Plate V2 mounting holes.0003.dwg, Top Plate V2 mounting holes.dwg, Top Plate V2.2.0019.ipt, Top Plate V2.2.0021.ipt, Top Plate V2.2.ipt, lab view of cryostat.0001.iam, lab view of cryostat.iam, mini Cryostat FOOT3.0003.iam]
2018-10-26 didn't do anthing really
    [MARINE-CLEAT.0001.ipt, MARINE-CLEAT.STEP, MARINE-CLEAT.ipt, MARINE-CLEAT.stl, lab view of cryostat.0001.iam, lab view of cryostat.0002.iam, lab view of cryostat.iam, mini 55K stage.0011.ipt]
2018-11-01 some cad
    [2K8 stage mini.0003.ipt, 2K8 stage mini.ipt, 55K mini shield.0002.ipt, 55K mini shield.0003.ipt, 55K mini shield.ipt, 55K stage.0019.ipt, 55K stage.0020.ipt, 55K stage.ipt]
2018-11-05 drawings of bent feet
    [feet type 3 part 1.dwg, feet type 3 part 2.dwg, lab view of cryostat.0003.iam, lab view of cryostat.0004.iam, lab view of cryostat.iam, mini Cryostat FOOT3.0020.iam, mini Cryostat FOOT3.0021.iam, mini Cryostat FOOT3.iam]
2018-11-05 measured new 55K bolt pattern
    [Radiation Sheild 2K.0001.ipt, Radiation Sheild 2K.0003.ipt, Radiation Sheild 2K.ipt, feet type 3 part 1 hexagon stock.0002.ipt, feet type 3 part 1 hexagon stock.ipt]
2018-11-15 made a pulley
    [lab view of cryostat.0004.iam, lab view of cryostat.0005.iam, lab view of cryostat.iam, mini Cryostat FOOT3.0021.iam, mini Cryostat FOOT3.0022.iam, mini Cryostat FOOT3.iam, pulley holder.0001.ipt, pulley holder.ipt]
2018-11-19 table support cad made bigger
    [Cryostat.0015.iam, Cryostat.0016.iam, Cryostat.iam, Top Plate V3 back holes.stp, cy oring.ipt, lab view of cryostat.0005.iam, lab view of cryostat.0006.iam, lab view of cryostat.iam]
2018-11-30 bolt size is wrong for pt cooler
    [Top Plate V2.2.0022.ipt, Top Plate V2.2.0023.ipt, Top Plate V2.2.ipt]
2018-12-17 2.8k stage fixed legs
    [2K8 FEET.0003.iam, 2K8 FEET.0004.iam, 2K8 FEET.iam, 8 trace.0001.ipt, 8 trace.dwg, 8 trace.ipt, TF JunctionBoard.0002.ipt, TF JunctionBoard.dwg]
2019-01-07 workin on the report
    [PT415 Cooling Power.xlsx, feet type 3 part 3.0003.ipt, feet type 3 part 3.0004.ipt, feet type 3 part 3.ipt, foot type 3.0002.iam, foot type 3.0003.iam, foot type 3.iam, lab view of cryostat.0007.iam]
2019-01-14 new still pipe
    [2K8 stage mini.0006.ipt, 2K8 stage mini.0007.ipt, 2K8 stage mini.ipt, KF50 bellows.ipt, feet type 3 part 1 hexagon stock 10-32 hole.0001.ipt, feet type 3 part 1 hexagon stock 10-32 hole.0002.ipt, feet type 3 part 1 hexagon stock 10-32 hole.ipt, feet type 3 part 2 hex stock 10-32.0001.ipt]
2019-03-04 still pipe drawing
    [KF50 bellows.0002.ipt, KF50 bellows.0003.ipt, KF50 bellows.ipt, foot type 3.0003.iam, foot type 3.0006.iam, foot type 3.iam, mini Cryostat FOOT3.0031.iam, mini Cryostat FOOT3.0032.iam]
2019-03-04 still pipe
    [0in5 ss pipe.0001.ipt, 0in5 ss pipe.ipt, 1in ss pipe.0002.ipt, 1in ss pipe.0005.ipt, 1in ss pipe.ipt, KF50 bellows.0003.ipt, KF50 bellows.0006.ipt, KF50 bellows.ipt]
2020-12-19 Final commit.
    [minifridge.0001.ipt, minifridge.0004.ipt, minifridge.ipt]
